HenriqDV/controlador-cultivo-esp32/docs/img/painel-automacao.png

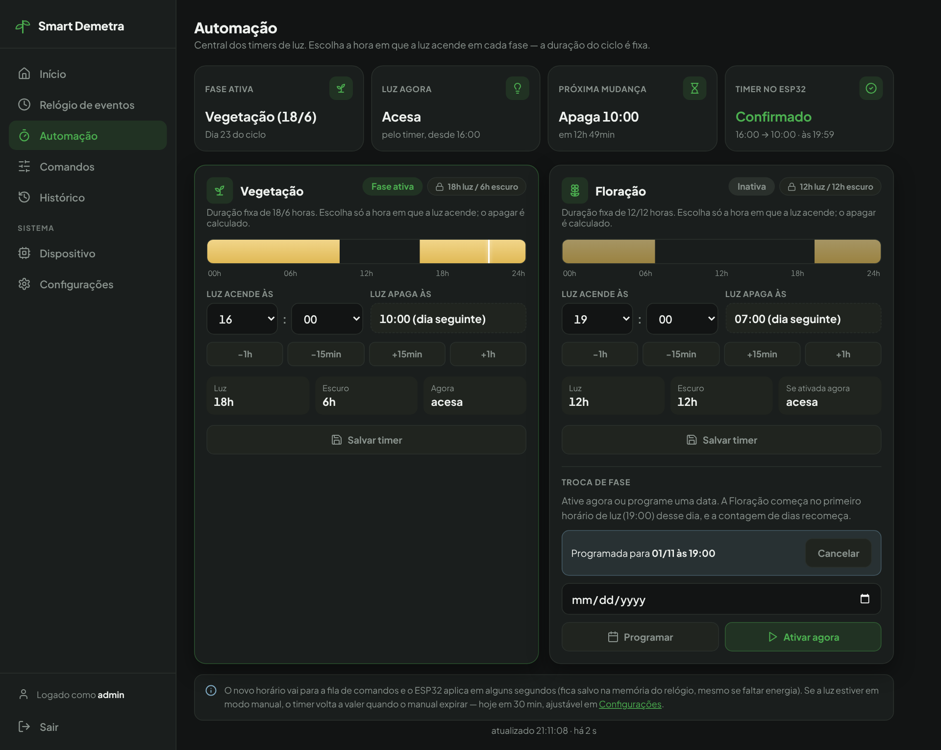
docs/img/painel-automacao.png
