HenriqDV/controlador-cultivo-esp32/src/main.cpp

// =============================================================================
//  CULTIVO — automação de estufa (ESP32-S3)
// =============================================================================
//  Luz (fotoperíodo + override manual), exaustores, trava de acesso e sensores
//  de temperatura/umidade do ar e do solo. Interface local: OLED SSD1306 +
//  botão. Interface remota: dashboard na Hostinger (pasta hostinger/), que o
//  ESP32 consulta por HTTPS (conexão reaproveitada), com o estado atual a cada
//  5 s para o painel ficar ao vivo. A rede roda numa tarefa no núcleo 0; o loop() fica no núcleo 1.
//  Não há servidor HTTP no dispositivo.
//  Gravação do firmware só por USB.
//
//  WOKWI_SIMULATION: 1 = simulador (DHT22; SSID "Wokwi-GUEST" no secrets.h)
//                    0 = hardware (SHT40 via I2C)
//
//  PINOS
//    I2C (OLED + RTC DS1307 + SHT40): SDA 8, SCL 9
//    Solo capacitivo v1.2 (ADC) 6 | Caixa d'água HC-SR04: TRIG 12, ECHO 13 (com divisor 5V->3,3V)
//    DHT externo 16 | DHT interno 15 (só simulação)
//    Buzzer 17 | NeoPixel 4 (Wokwi) / 48 (placa) | Botão OLED 5 | Botão trava 19
//    Relés {42,41,40,39,38,37,36,35}:
//      0 Luz  1 Irrigacao (pino 41)  2 Ventilador  3 Umidificador (pino 39)
//      4 Entrada de Ar (pino 38)  5 Aquecedor (pino 37)  6 Trava  7 Saída de Ar
//
//  NVRAM do RTC: bytes 0-7 relés/modo/override da luz, 8-12 horários de luz.
//  Cópia de tudo isso na flash (NVS "estado"), que não depende da bateria do RTC.
//  NVS "clima": clima por VPD (fase, faixa de VPD e travas do aquecedor/umidificador).
//
//  CALIBRAR NO HARDWARE: SOLO_MV_SECO/SOLO_MV_UMIDO, AGUA_SENSOR_ATE_FUNDO_CM, RELE_ATIVO_EM_BAIXO.
// =============================================================================

// Necessário em .cpp (o .ino incluía automaticamente).
#include <Arduino.h>
#include <Wire.h>
#include <Adafruit_GFX.h>
#include <Adafruit_SSD1306.h>
#include <RTClib.h>
#define WOKWI_SIMULATION 0

// Versão enviada ao painel (tela Dispositivo). Atualize a cada nova gravação.
#define FIRMWARE_VERSAO "2.9.0"
#if !WOKWI_SIMULATION
#include <Adafruit_SHT4x.h>
#endif
#include <DHT.h>
#include <Adafruit_NeoPixel.h>
#include <WiFi.h>
#include <WiFiClientSecure.h>
#include <HTTPClient.h>
#include <esp_task_wdt.h>
#include <ArduinoJson.h>
#include <Preferences.h>
#include <WiFiManager.h>
#include <time.h>
#include <math.h>

// Copie secrets.example.h para secrets.h (não versionado) e preencha.
#include "secrets.h"

// ---------------- WIFI E CONEXÃO COM O PAINEL ----------------
// O portal "SmartDemetra-Setup" (192.168.4.1) grava rede, endereço do painel e token
// na memória (NVS). Sem nada gravado, valem os valores do secrets.h.
const char* PORTAL_SSID = "SmartDemetra-Setup";
const unsigned long PORTAL_TIMEOUT_S = 300;         // fecha o portal após 5 min
const unsigned long BOTAO_PORTAL_MS = 3000;         // segurar o botão do OLED ao ligar
const unsigned long RETENTATIVA_VINCULO_MS = 30000;
const char* TOKEN_HW_PREFIXO = "sd_hw_";
Preferences prefs;
String cfgSsid, cfgSenha, cfgUrl, cfgToken, cfgVinculo;
unsigned long ultimaTentativaVinculoEm = 0;

// Envio de leitura pra Hostinger (independente do histórico local).
const unsigned long INTERVALO_ENVIO_LEITURA_HOSTINGER_MS = 60UL * 1000UL; // 1 minuto
unsigned long ultimoEnvioLeituraHostingerEm = 0;

const long GMT_OFFSET_SEC = -3 * 3600;
const int DAYLIGHT_OFFSET_SEC = 0;
const unsigned long WIFI_TIMEOUT_MS = 15000;
const unsigned long RETENTATIVA_WIFI_INICIAL_MS = 5000;
const unsigned long RETENTATIVA_WIFI_POSTERIOR_MS = 30000;
const unsigned long JANELA_WIFI_INICIAL_MS = 60000;
const unsigned long NTP_TIMEOUT_MS = 10000;
const unsigned long RETENTATIVA_NTP_MS = 60000;

// ---------------- PRAZOS COM millis() ----------------
// millis() volta a zero a cada 49,7 dias. Comparar "millis() >= prazo" falha perto da virada
// (ex.: a luz manual desligaria na hora). A diferença com sinal continua certa na virada.
inline bool prazoVencido(unsigned long prazo) { return (long)(millis() - prazo) >= 0; }
inline unsigned long msAtePrazo(unsigned long prazo) {
  long restante = (long)(prazo - millis());
  return restante > 0 ? (unsigned long)restante : 0;
}

// ---------------- HOSTINGER ----------------
// Toda a rede (HTTPS) roda numa tarefa própria no núcleo 0 (tarefaRede).
// O loop() fica no núcleo 1 com sensores, relés, OLED e clima, e nunca espera o servidor.
// As duas partes conversam só pelo que está protegido por mtxRede e pela fila de comandos.
const unsigned long HOSTINGER_HTTP_TIMEOUT_MS = 7000;
const unsigned long INTERVALO_ENVIO_COMANDOS_HOSTINGER_MS = 250; // eventos saem quase na hora
const int HOSTINGER_FILA_COMANDOS_MAX = 30;
String filaComandosHostinger[HOSTINGER_FILA_COMANDOS_MAX];   // protegida por mtxRede
int filaComandosInicio = 0;
int filaComandosFim = 0;
int filaComandosTotal = 0;
unsigned long ultimoEnvioComandoHostingerEm = 0;              // só na tarefa de rede

// Estado ao vivo pela própria Hostinger: leituras e relés a cada 5 s em estado_atual.php.
// O servidor guarda só o último (não cresce o banco); o histórico continua com 1 leitura por minuto.
const unsigned long INTERVALO_ESTADO_HOSTINGER_MS = 5000;
unsigned long ultimoEstadoHostingerEm = 0;                    // loop()

// Polling da fila de comandos do dashboard.
const unsigned long INTERVALO_POLL_COMANDOS_HOSTINGER_MS = 4UL * 1000UL; // 4 segundos
unsigned long ultimaConsultaComandosPendentesEm = 0;          // só na tarefa de rede

// ---------------- TAREFA DE REDE (núcleo 0) ----------------
const uint32_t TAREFA_REDE_PILHA = 16384;  // TLS precisa de pilha folgada
const UBaseType_t TAREFA_REDE_PRIORIDADE = 1;
const BaseType_t TAREFA_REDE_NUCLEO = 0;   // o loop() do Arduino roda no núcleo 1
SemaphoreHandle_t mtxRede = nullptr;       // protege filas e "caixas de correio" abaixo
QueueHandle_t filaComandosRemotos = nullptr; // rede -> loop(): comandos do painel a aplicar

struct ComandoRemoto {
  char tipo[24];
  char alvo[32];
  char valor[64];
};
const int FILA_COMANDOS_REMOTOS_MAX = 16;

// Caixas de correio loop() -> rede (sempre a versão mais recente; protegidas por mtxRede).
String leituraParaEnviar;
bool temLeituraParaEnviar = false;
String estadoParaHostinger;         // estado_atual.php
bool temEstadoParaHostinger = false;
// Rede -> loop(): mensagem curta para o OLED (ex.: "Vinculado!").
char mensagemRedeOLED[24] = "";
bool temMensagemRedeOLED = false;

// ---------------- VIGIA DA CONEXÃO ----------------
// O Wi-Fi pode continuar "conectado" sem os dados chegarem ao servidor (roteador sem internet,
// DNS, memória para TLS esgotada, conexão travada). Antes nada tentava recuperar: o aparelho
// seguia funcionando localmente sem enviar nada. O vigia (no loop) age em etapas:
//   3 min sem resposta do servidor  -> derruba e reconecta o Wi-Fi (repete a cada 3 min)
//   10 min sem resposta             -> reinicia o ESP32 (relés manuais, fase e luz voltam da memória)
//   tarefa de rede parada há 2 min  -> reinicia o ESP32
// Depois de 3 reinícios seguidos sem resposta (servidor fora do ar), só reinicia a cada 1 h.
// Qualquer resposta HTTP conta (até um erro 401/500 prova que a rede chega ao servidor).
const unsigned long VIGIA_INTERVALO_MS = 10000;
const unsigned long VIGIA_RECONECTAR_WIFI_MS = 3UL * 60UL * 1000UL;
const unsigned long VIGIA_REINICIAR_MS = 10UL * 60UL * 1000UL;
const unsigned long VIGIA_REINICIAR_ESPACADO_MS = 60UL * 60UL * 1000UL;
const unsigned long VIGIA_TAREFA_TRAVADA_MS = 2UL * 60UL * 1000UL;
const uint32_t VIGIA_REINICIOS_ANTES_DE_ESPACAR = 3;
const unsigned long STATUS_REDE_SERIAL_MS = 60000;
// Watchdog do loop(): se ele parar por mais que isto (ex.: barramento I2C travado), o ESP32 reinicia.
const uint32_t WATCHDOG_LOOP_S = 15;
volatile unsigned long ultimaRespostaServidorEm = 0;  // rede: qualquer resposta HTTP
volatile unsigned long ultimaVoltaTarefaRedeEm = 0;   // rede: prova de vida da tarefa
volatile uint32_t falhasSeguidasServidor = 0;         // rede
bool tarefaRedeIniciada = false;
unsigned long vigiaReferenciaEm = 0;                  // loop(): início da contagem (Wi-Fi conectado)
unsigned long ultimaVerificacaoVigiaEm = 0;
unsigned long ultimaReconexaoForcadaEm = 0;
unsigned long ultimoStatusRedeSerialEm = 0;
// Sobrevivem ao ESP.restart() (não à falta de energia): por que o vigia reiniciou.
const uint32_t VIGIA_MARCADOR = 0x56494741;
RTC_NOINIT_ATTR uint32_t vigiaMarcador;
RTC_NOINIT_ATTR uint32_t vigiaReiniciosSeguidos;
RTC_NOINIT_ATTR uint32_t vigiaMotivo;          // 0 = nenhum, 1 = sem resposta do servidor, 2 = tarefa de rede travada
RTC_NOINIT_ATTR uint32_t vigiaSemRespostaSeg;

// Trava o mutex no construtor e solta no destrutor (não esquece de soltar em return).
struct TravaRede {
  TravaRede() { xSemaphoreTake(mtxRede, portMAX_DELAY); }
  ~TravaRede() { xSemaphoreGive(mtxRede); }
};


// ---------------- PINOS ----------------
#define SDA_PIN 8
#define SCL_PIN 9

#if WOKWI_SIMULATION
#define DHTPIN 15
#define DHTTYPE DHT22
#endif

// Sensor externo: DHT11 no hardware, DHT22 no Wokwi.
#define DHT_EXT_PIN 16
#if WOKWI_SIMULATION
#define DHT_EXT_TYPE DHT22
#else
#define DHT_EXT_TYPE DHT11
#endif

#define SOIL_PIN 6

// ---------------- SENSOR DE SOLO: Capacitive Soil Moisture Sensor v1.2 ----------------
// Saída analógica que CAI com a umidade: ~2,7 V no ar (seco) e ~1,1 V na água, alimentado em 3,3 V.
// Lido em milivolts (analogReadMilliVolts usa a calibração de fábrica do ADC do ESP32-S3).
// CALIBRAR: veja "Solo - mV" no monitor serial com o sensor no ar (SOLO_MV_SECO) e com ele
// mergulhado em água até a linha branca da placa, sem molhar os componentes (SOLO_MV_UMIDO).
const int SOLO_MV_SECO = 2700;           // mV com o sensor no ar
const int SOLO_MV_UMIDO = 1100;          // mV com o sensor na água
const int SOLO_MV_MINIMO_VALIDO = 300;   // abaixo: sensor solto ou sem alimentação
const int SOLO_MV_MAXIMO_VALIDO = 3150;  // acima: fio de sinal solto (entrada flutuando)
const int SOLO_AMOSTRAS = 16;            // leituras por ciclo; descarta as 4 maiores e as 4 menores
const int SOLO_FALHAS_PARA_INVALIDAR = 3; // ciclos seguidos fora da faixa até marcar "sem leitura"

// ---------------- CAIXA D'ÁGUA: sensor ultrassônico HC-SR04 ----------------
// Fica na tampa, virado para baixo. O ECHO do HC-SR04 sai em 5 V: ligue por um divisor
// (ECHO -> 1 kΩ -> pino 13 -> 2 kΩ -> GND) para não danificar o ESP32-S3. VCC em 5 V.
#define AGUA_TRIG_PIN 12
#define AGUA_ECHO_PIN 13
const float CAIXA_COMPRIMENTO_CM = 66.0f;
const float CAIXA_LARGURA_CM = 36.0f;
const float CAIXA_ALTURA_CM = 35.0f;
const float CAIXA_CAPACIDADE_L = 70.0f;        // capacidade útil (100%); paredes retas, 66 x 36 = 2,376 L por cm (70 L = 29,5 cm)
const float AGUA_SENSOR_ATE_FUNDO_CM = 35.0f;  // CALIBRAR: da face do sensor até o fundo (caixa vazia)
const float AGUA_DISTANCIA_MINIMA_CM = 3.0f;   // zona cega do HC-SR04
const unsigned long INTERVALO_AGUA_MS = 10000; // mede a cada 10 s
const int AGUA_PINGS = 5;                      // usa a mediana de 5 medições
const unsigned long AGUA_ENTRE_PINGS_MS = 70;  // espera o eco anterior sumir
const unsigned long AGUA_TIMEOUT_US = 6000;    // ~1 m ida e volta; não trava o loop
const int AGUA_FALHAS_PARA_INVALIDAR = 3;      // ciclos seguidos sem eco até marcar "sem leitura"
const float AGUA_PROTECAO_IRRIGACAO_PCT = 10.0f; // abaixo disso a irrigação desliga e fica bloqueada (bomba não roda a seco)

#define BOTAO_OLED_PIN 5
#define BOTAO_TRV_PIN 19

#define BUZZER 17

// NeoPixel: LED externo no Wokwi, LED RGB da placa no hardware.
#if WOKWI_SIMULATION
#define LED_PIN 4
#else
#define LED_PIN 48
#endif

// Troque para false se os relés ligarem invertidos.
#define RELE_ATIVO_EM_BAIXO true

int reles[8] = {42, 41, 40, 39, 38, 37, 36, 35};
// Placas com PSRAM Octal (ex.: N16R8) reservam GPIO35-37: remapeie se for o caso.

// ---------------- ÍNDICES DOS RELÉS ----------------
const int TOTAL_RELES = 8;           // índices 0-7
const int RELE_LUZ = 0;              // ver controlarLuz()
const int RELE_IRRIGACAO = 1;        // "Irrigacao" (pino 41)
const int RELE_VENTILADOR = 2;       // "Ventilador"
const int RELE_UMIDIFICADOR = 3;     // "Umidificador" (pino 39)
const int RELE_ENTRADA_AR = 4;       // "Entrada de Ar" (pino 38)
const int RELE_AQUECEDOR = 5;        // "Aquecedor" (pino 37)
const int RELE_ACESSO = 6;           // trava (pulso)
const int RELE_SAIDA_AR = 7;         // "Saida de Ar" (exaustor de saída)
const int PRIMEIRO_RELE_MANUAL = 1;  // menor índice de relé "manual" (usado só como limite de segurança)
const int CONTROLE_MODO_CULTIVO = -1; // sentinela: item de menu "Modo Cultivo" (não é relé de verdade)
const int CONTROLE_LUZ_MANUAL = -2;   // sentinela: item de menu "Luz Manual" (override, não é relé de verdade)

// Relés exibidos no menu e no dashboard (luz e trava têm controle próprio).
const int RELES_MANUAIS[] = {RELE_IRRIGACAO, RELE_VENTILADOR, RELE_UMIDIFICADOR, RELE_ENTRADA_AR, RELE_AQUECEDOR, RELE_SAIDA_AR};
const int TOTAL_RELES_MANUAIS = sizeof(RELES_MANUAIS) / sizeof(RELES_MANUAIS[0]);

// ---------------- DISPLAY OLED ----------------
#define SCREEN_WIDTH 128
#define SCREEN_HEIGHT 64
#define OLED_RESET -1
#define SCREEN_ADDRESS 0x3C
Adafruit_SSD1306 display(SCREEN_WIDTH, SCREEN_HEIGHT, &Wire, OLED_RESET);

// Painel com faixa amarela de 16px no topo.
const int OLED_ALTURA_CABECALHO = 16;                       // faixa amarela (linhas 0-15)
const int OLED_CONTEUDO_TOPO = OLED_ALTURA_CABECALHO + 2;    // margem de 2px após a costura

// ---------------- OBJETOS ----------------
RTC_DS1307 rtc;
#if WOKWI_SIMULATION
DHT dht(DHTPIN, DHTTYPE);
#else
Adafruit_SHT4x sht4 = Adafruit_SHT4x();
#endif
DHT dhtExterno(DHT_EXT_PIN, DHT_EXT_TYPE);
Adafruit_NeoPixel pixel(1, LED_PIN, NEO_GRB + NEO_KHZ800);

// ---------------- LED (cor = zona do VPD) ----------------
unsigned long tempoLED = 0; // efeito a cada 20ms
int brilho = 30;
int direcao = 5; // sentido do "respirar" (+ = aumentando, - = diminuindo)
const int LED_BRILHO_MIN = 30;  // nunca apaga de vez — sempre dá pra ver a cor
const int LED_BRILHO_MAX = 150;

// ---------------- CULTIVO ----------------
enum ModoCultivo { VEGETACAO, FLORACAO };
ModoCultivo modoAtual = VEGETACAO;

// Fotoperíodo: início configurável pelo dashboard, duração fixa (18/6 e 12/12).
const int DURACAO_LUZ_VEGETACAO_MIN = 18 * 60;
const int DURACAO_LUZ_FLORACAO_MIN = 12 * 60;
const int INICIO_LUZ_VEGETACAO_PADRAO_MIN = 16 * 60;
const int INICIO_LUZ_FLORACAO_PADRAO_MIN = 19 * 60;
int inicioLuzVegetacaoMin = INICIO_LUZ_VEGETACAO_PADRAO_MIN;
int inicioLuzFloracaoMin = INICIO_LUZ_FLORACAO_PADRAO_MIN;

// Override manual da luz: expira sozinho e o timer segue contando por baixo.
enum ModoControleLuz { LUZ_AUTOMATICA, LUZ_MANUAL_LIGADA, LUZ_MANUAL_DESLIGADA };
ModoControleLuz modoControleLuz = LUZ_AUTOMATICA;
unsigned long overrideLuzAte = 0;
const unsigned long DURACAO_OVERRIDE_LUZ_MS = 30UL * 60UL * 1000UL; // padrão, se o painel não enviar outra
int duracaoOverrideLuzMin = 30;  // 15, 30, 60 ou 120 (Configurações → Luz, salvo na flash e no RTC)
const int DURACAO_LUZ_MANUAL_MAX_MIN = 120;
unsigned long duracaoOverrideLuzMs() {
  return duracaoOverrideLuzMin > 0 ? (unsigned long)duracaoOverrideLuzMin * 60UL * 1000UL : DURACAO_OVERRIDE_LUZ_MS;
}

// ---------------- OLED / BOTÃO ----------------
// Clique curto: próxima tela/item. Clique longo: entra no menu/alterna item.
enum TelaOLED {
  TELA_PRINCIPAL,      // temperatura/umidade interna e externa
  TELA_CONFIGURACAO,    // menu com abas "Dispositivos" (relés) e "Status"
  TOTAL_TELAS_OLED
};

enum EstadoOLED {
  OLED_DESCANSO,   // tela de descanso
  OLED_MENU,       // aguardando clique longo
  OLED_EXIBINDO,   // exibindo uma TelaOLED
  OLED_MENSAGEM    // mensagem temporária centralizada (ex: "Modo: Floracao")
};

EstadoOLED estadoOLED = OLED_DESCANSO;
TelaOLED telaSelecionada = TELA_PRINCIPAL;
bool mensagemTemporariaAtiva = false;
unsigned long mensagemAte = 0;      // timestamp em que a mensagem temporária deve sumir
String linha1Mensagem = "";
bool atualizarOLED = true;          // "dirty flag": true = precisa redesenhar no próximo loop()
unsigned long oledVoltaDescansoEm = 0; // volta ao descanso (0 = desativado)
unsigned long ultimoRefreshPeriodicoOLED = 0; // ver INTERVALO_REFRESH_PERIODICO_MS, no loop()

// --- Debounce e detecção de clique curto/longo do botão físico ---
bool ultimoEstadoBotao = HIGH;
bool estadoEstavelBotaoOLED = HIGH;
bool botaoPressionado = false;
unsigned long botaoMudouEm = 0;
unsigned long botaoPressionadoEm = 0;
const unsigned long DEBOUNCE_BOTAO_MS = 50;    // ignora oscilações do contato mecânico abaixo disso
const unsigned long PRESSAO_LONGA_MS = 1200;   // acima disso, conta como "clique longo"
const unsigned long TEMPO_EXIBICAO_OLED_MS = 15000; // tempo de inatividade até voltar pra tela de descanso
const unsigned long INTERVALO_REFRESH_PERIODICO_MS = 1000; // redesenho periódico
const unsigned long INTERVALO_ANIMACAO_DESCANSO_MS = 60;   // ~16 fps para a animação sol/lua
unsigned long ultimoFrameAnimacaoDescanso = 0;
int releSelecionadoControle = CONTROLE_MODO_CULTIVO; // item atualmente destacado no menu de configuração

// ---------------- SENSOR DE AR (DHT22 no Wokwi / SHT40 no hardware) ----------------
float tempAtual = NAN;
float umidAtual = NAN;
unsigned long ultimoDHT = 0;
const unsigned long INTERVALO_DHT_MS = 2000; // intervalo mínimo recomendado p/ DHT22; SHT40 aceita mais rápido
bool pulsoSensorAtivo = false;      // indicador visual de "sensor vivo" (bolinha ao lado de "Interna", na TELA_PRINCIPAL)
unsigned long pulsoSensorAte = 0;
const unsigned long DURACAO_PULSO_SENSOR_MS = 300; // por quanto tempo o pulso fica visível a cada leitura

// ---------------- SENSOR EXTERNO (DHT) ----------------
float tempExterna = NAN;
float umidExterna = NAN;
unsigned long ultimoDHTExterno = 0;
const unsigned long INTERVALO_DHT_EXTERNO_MS = 2000; // seguro tanto para DHT11 (>=1s) quanto DHT22 (>=2s)
bool pulsoSensorExternoAtivo = false;
unsigned long pulsoSensorExternoAte = 0;

// ---------------- SOLO ----------------
int soloMv = 0;          // leitura em mV (útil p/ calibrar)
int soloPercentual = 0;  // 0 = seco, 100 = encharcado, já calibrado
bool soloValido = false; // false = sensor sem leitura (solto/sem alimentação); envia null ao servidor
int soloFalhas = 0;

// Caixa d'água (NAN = sem leitura)
float aguaDistanciaCm = NAN;
float aguaNivelCm = NAN;
float aguaLitros = NAN;
float aguaPercentual = NAN;
float pingsAgua[AGUA_PINGS];
int pingsAguaFeitos = 0;
int aguaFalhas = 0;
unsigned long ultimoCicloAguaEm = 0;
unsigned long ultimoPingAguaEm = 0;
unsigned long ultimoSolo = 0;
const unsigned long INTERVALO_SOLO_MS = 1000;
bool pulsoSensorSoloAtivo = false;  // indicador visual de "sensor vivo" (bolinha ao lado de "Solo", na TELA_PRINCIPAL)
unsigned long pulsoSensorSoloAte = 0;

// ---------------- BUZZER (não bloqueante) ----------------
bool buzzerLigado = false;
unsigned long buzzerDesligaEm = 0;

// ---------------- ACESSO (trava, pulso) ----------------
bool acessoAtivo = false;
unsigned long acessoDesligaEm = 0;

// ---------------- STATUS (conectividade e sincronismo) ----------------
bool rtcDisponivel = false;             // RTC DS1307 detectado no I2C
bool rtcPerdeuHora = false;             // RTC estava parado ao ligar (sem bateria): hora não confiável até o NTP
#if !WOKWI_SIMULATION
bool sht40Disponivel = false;           // SHT40 detectado (hardware)
#endif
bool wifiConectado = false;
bool horaSincronizada = false;          // NTP sincronizado desde o boot
unsigned long ultimaTentativaWiFi = 0;
unsigned long wifiDesconectadoDesde = 0;
unsigned long ultimaTentativaNTP = 0;
unsigned long ultimaInteracaoMenuEm = 0;      // marca a última interação local com o menu do OLED

// ---------------- ESTADO DOS RELÉS (escrito só por acionarRele()) ----------------
bool estadoReles[TOTAL_RELES] = {false, false, false, false, false, false, false, false};

// ---------------- PROTÓTIPOS ----------------
void beep(unsigned long tempo = 200);
void avancarReleControle();
void alternarReleSelecionado();
void alternarModoCultivo();
void alternarModoControleLuz();
bool telaInterativa(TelaOLED tela);
TelaOLED proximaTelaOLED(TelaOLED telaAtualBase);
void abrirTelaRapidaOLED();
void avancarNavegacaoOLED();
const char* nomeReleControle(int indiceRele);
bool conectarWiFi();
void atualizarConexaoWiFi();
String obterTimestampAtual();
void registrarEventoModo(const char* estadoModo, const char* origem = "sistema");
void registrarEventoAcesso(const char* origem, const char* resultado);
void registrarEventoRele(int indiceRele, bool ligado, const char* origem);
bool enviarJsonHostinger(const char* endpoint, const String& payload);
void enviarLeituraHostinger();
void atualizarEnvioLeituraHostinger();
void enfileirarComandoHostinger(const char* tipo, const char* alvo, const String& valor, const char* origem);
void atualizarFilaComandosHostinger();
String valorJsonFloat(float valor, int casas);
String escaparJson(const String& valor);
float calcularVPD(float tempC, float umidPercent);
uint32_t corParaVPD(float vpd);
void atualizarLEDVPD();
void aplicarComandoRele(int indiceRele, int valor);
void acionarRele(int numero, bool ligado);
void pausarClimaDoRele(int indiceRele, const char* origem);
void definirModoCultivoRemoto(ModoCultivo novoModo);
void definirModoControleLuzRemoto(ModoControleLuz novoModo);
void liberarAcessoRemoto();
DateTime obterAgora();
String tempoRestante(const DateTime& now);
String tempoRestanteOverrideLuz();
void salvarEstadoNaMemoria();
void restaurarEstadoDaMemoria();
void salvarFotoperiodoNaMemoria();
void restaurarFotoperiodoDaMemoria();
void registrarEventoFotoperiodo(ModoCultivo modo, const char* origem);
void definirFotoperiodoRemoto(ModoCultivo modo, int inicioMin);
void mensagemInicializacao(const String& linha1, const String& linha2 = "");
void atualizarComandosPendentesHostinger();
void aplicarComandoRemotoWeb(const String& tipo, const String& alvo, const String& valor);
int requisicaoHttps(const char* endpoint, const String* corpo, bool comChave, String* resposta);
void avisarOLEDPelaRede(const char* texto);
String montarJsonEstado();
void mostrarMensagemTemporaria(const String& linha1, unsigned long duracaoMs);

// ---------------- VPD ----------------
// VPD (kPa) = 0.6108 * e^(17.27*T/(T+237.3)) * (1 - UR/100)
float calcularVPD(float tempC, float umidPercent) {
  float svp = 0.6108 * exp((17.27 * tempC) / (tempC + 237.3));
  return svp * (1.0 - umidPercent / 100.0);
}

// Zonas: <0.4 muito úmido | 0.4-0.8 propagação | 0.8-1.2 veg tardio/flora inicial
//        | 1.2-1.6 flora | >1.6 muito seco
uint32_t corParaVPD(float vpd) {
  if (vpd < 0.4) {
    return pixel.Color(171, 0, 37);     // rosa fraco #AB0025 — muito úmido
  } else if (vpd < 0.8) {
    return pixel.Color(254, 105, 255);  // rosa forte #FE69FF — propagação/veg inicial
  } else if (vpd < 1.2) {
    return pixel.Color(14, 173, 49);    // verde #0EAD31 — fim de veg / início de flora
  } else if (vpd < 1.6) {
    return pixel.Color(219, 203, 15);   // laranja #DBCB0F — flora média/tardia
  } else {
    return pixel.Color(171, 0, 37);     // rosa fraco #AB0025 — muito seco
  }
}

// Cor pela zona do VPD com efeito de respiração (~50Hz).
void atualizarLEDVPD() {
  if (millis() - tempoLED < 20) return;
  tempoLED = millis();

  brilho += direcao;
  if (brilho >= LED_BRILHO_MAX) {
    brilho = LED_BRILHO_MAX;
    direcao = -5;
  }
  if (brilho <= LED_BRILHO_MIN) {
    brilho = LED_BRILHO_MIN;
    direcao = 5;
  }

  if (isnan(tempAtual) || isnan(umidAtual)) {
    // Sem leitura ainda: branco fraco.
    uint8_t nivel = brilho / 3;
    pixel.setPixelColor(0, pixel.Color(nivel, nivel, nivel));
  } else {
    uint32_t corBase = corParaVPD(calcularVPD(tempAtual, umidAtual));
    uint8_t rBase = (corBase >> 16) & 0xFF;
    uint8_t gBase = (corBase >> 8) & 0xFF;
    uint8_t bBase = corBase & 0xFF;
    uint8_t r = (uint16_t)rBase * brilho / LED_BRILHO_MAX;
    uint8_t g = (uint16_t)gBase * brilho / LED_BRILHO_MAX;
    uint8_t b = (uint16_t)bBase * brilho / LED_BRILHO_MAX;
    pixel.setPixelColor(0, pixel.Color(r, g, b));
  }

  pixel.show();
}

// Proteção da bomba: com a caixa abaixo de 10% a irrigação não liga. Sem leitura do sensor, não bloqueia.
bool irrigacaoBloqueadaPelaAgua() {
  return !isnan(aguaPercentual) && aguaPercentual < AGUA_PROTECAO_IRRIGACAO_PCT;
}

// Comando de relé vindo do dashboard; ignora se o estado já é o pedido.
void aplicarComandoRele(int indiceRele, int valor) {
  bool novoEstado = valor == 1;
  if (indiceRele == RELE_IRRIGACAO && novoEstado && irrigacaoBloqueadaPelaAgua()) {
    // Recusa e confirma ao painel que a irrigação continua desligada.
    registrarEventoRele(RELE_IRRIGACAO, false, "bloqueio_agua");
    Serial.println("Irrigacao bloqueada: caixa d'agua abaixo de 10%");
    return;
  }
  pausarClimaDoRele(indiceRele, "web"); // comando manual tem prioridade sobre o clima por VPD
  if (estadoReles[indiceRele] == novoEstado) return;

  acionarRele(indiceRele, novoEstado);
  registrarEventoRele(indiceRele, novoEstado, "web");
  salvarEstadoNaMemoria();
  atualizarOLED = true;
}

// =========================================================================
//                              OLED - SSD1306
// =========================================================================

// Mensagem centralizada por duracaoMs; depois volta à tela de descanso.
void mostrarMensagemTemporaria(const String& linha1, unsigned long duracaoMs) {
  estadoOLED = OLED_MENSAGEM;
  linha1Mensagem = linha1;
  mensagemTemporariaAtiva = true;
  mensagemAte = millis() + duracaoMs;
  oledVoltaDescansoEm = mensagemAte;
  atualizarOLED = true;
}

// Fecha a mensagem temporária quando o tempo expira (chamada a cada loop()).
void atualizarMensagemTemporaria() {
  if (mensagemTemporariaAtiva && prazoVencido(mensagemAte)) {
    mensagemTemporariaAtiva = false;
    atualizarOLED = true;
  }
}

bool telaInterativa(TelaOLED tela) {
  return tela == TELA_CONFIGURACAO;
}

TelaOLED proximaTelaOLED(TelaOLED telaAtualBase) {
  int proximaTela = static_cast<int>(telaAtualBase) + 1;
  if (proximaTela >= TOTAL_TELAS_OLED) {
    proximaTela = 0;
  }
  return static_cast<TelaOLED>(proximaTela);
}

void abrirTelaRapidaOLED() {
  telaSelecionada = TELA_PRINCIPAL;
  estadoOLED = OLED_EXIBINDO;
  oledVoltaDescansoEm = millis() + TEMPO_EXIBICAO_OLED_MS;
  ultimaInteracaoMenuEm = millis();
  atualizarOLED = true;
}

// Clique longo no menu: abre a lista de dispositivos no primeiro item.
void selecionarTelaOLED() {
  estadoOLED = OLED_EXIBINDO;
  if (telaSelecionada == TELA_CONFIGURACAO) {
    releSelecionadoControle = CONTROLE_MODO_CULTIVO;
  }
  oledVoltaDescansoEm = millis() + TEMPO_EXIBICAO_OLED_MS;
  ultimaInteracaoMenuEm = millis();
  atualizarOLED = true;
}

// Volta à tela de descanso após o tempo sem interação.
void atualizarTimeoutOLED() {
  if (estadoOLED != OLED_DESCANSO && oledVoltaDescansoEm != 0 && prazoVencido(oledVoltaDescansoEm)) {
    estadoOLED = OLED_DESCANSO;
    mensagemTemporariaAtiva = false;
    oledVoltaDescansoEm = 0;
    atualizarOLED = true;
  }
}

// Telas interativas param em OLED_MENU aguardando clique longo.
void avancarNavegacaoOLED() {
  telaSelecionada = proximaTelaOLED(telaSelecionada);
  estadoOLED = telaInterativa(telaSelecionada) ? OLED_MENU : OLED_EXIBINDO;
  oledVoltaDescansoEm = millis() + TEMPO_EXIBICAO_OLED_MS;
  ultimaInteracaoMenuEm = millis();
  atualizarOLED = true;
}

// Clique curto: acorda o display, alterna Informações/Configurações ou avança item.
void tratarCliqueCurtoBotaoOLED() {
  if (estadoOLED == OLED_DESCANSO) {
    abrirTelaRapidaOLED();
    return;
  }

  if (estadoOLED == OLED_EXIBINDO && telaSelecionada == TELA_CONFIGURACAO) {
    avancarReleControle();
    return;
  }

  if (estadoOLED == OLED_EXIBINDO || estadoOLED == OLED_MENU) {
    avancarNavegacaoOLED();
  }
}

// Debounce + diferencia clique curto de longo.
void atualizarBotaoOLED() {
  bool leitura = digitalRead(BOTAO_OLED_PIN);

  if (leitura != ultimoEstadoBotao) {
    botaoMudouEm = millis();
    ultimoEstadoBotao = leitura;
  }

  if (millis() - botaoMudouEm < DEBOUNCE_BOTAO_MS) {
    return;
  }

  if (leitura == estadoEstavelBotaoOLED) {
    return;
  }

  estadoEstavelBotaoOLED = leitura;
  ultimaInteracaoMenuEm = millis();

  if (estadoEstavelBotaoOLED == LOW) {
    botaoPressionado = true;
    botaoPressionadoEm = millis();
    return;
  }

  if (botaoPressionado) {
    unsigned long tempoPressionado = millis() - botaoPressionadoEm;
    botaoPressionado = false;

    if (tempoPressionado >= PRESSAO_LONGA_MS && estadoOLED == OLED_MENU) {
      beep(80);
      selecionarTelaOLED();
    } else if (tempoPressionado >= PRESSAO_LONGA_MS &&
               estadoOLED == OLED_EXIBINDO &&
               telaSelecionada == TELA_CONFIGURACAO) {
      beep(80);
      alternarReleSelecionado();
    } else if (tempoPressionado >= DEBOUNCE_BOTAO_MS) {
      beep(80);
      tratarCliqueCurtoBotaoOLED();
    }
  }
}

// ---------- desenho: primitivas auxiliares ----------

// Ícone de WiFi desenhado pixel a pixel (vazio quando desconectado).
void desenharIconeConexao(int x, int y) {
  if (!wifiConectado) return;

  int cx = x + 4; // centro horizontal do ícone
  int cy = y + 7; // "base" do leque (pontinho fica aqui)

  // Pontinho central
  display.drawPixel(cx, cy, SSD1306_WHITE);

  // Arco interno
  display.drawPixel(cx - 2, cy - 2, SSD1306_WHITE);
  display.drawPixel(cx - 1, cy - 3, SSD1306_WHITE);
  display.drawPixel(cx,     cy - 3, SSD1306_WHITE);
  display.drawPixel(cx + 1, cy - 3, SSD1306_WHITE);
  display.drawPixel(cx + 2, cy - 2, SSD1306_WHITE);

  // Arco externo
  display.drawPixel(cx - 5, cy - 3, SSD1306_WHITE);
  display.drawPixel(cx - 4, cy - 4, SSD1306_WHITE);
  display.drawPixel(cx - 3, cy - 5, SSD1306_WHITE);
  display.drawPixel(cx - 2, cy - 6, SSD1306_WHITE);
  display.drawPixel(cx - 1, cy - 6, SSD1306_WHITE);
  display.drawPixel(cx,     cy - 6, SSD1306_WHITE);
  display.drawPixel(cx + 1, cy - 6, SSD1306_WHITE);
  display.drawPixel(cx + 2, cy - 6, SSD1306_WHITE);
  display.drawPixel(cx + 3, cy - 5, SSD1306_WHITE);
  display.drawPixel(cx + 4, cy - 4, SSD1306_WHITE);
  display.drawPixel(cx + 5, cy - 3, SSD1306_WHITE);
}

// Cabeçalho comum: título, hora, modo (V/F) e WiFi; ocupa a faixa amarela.
void desenharCabecalho(const DateTime& now, const char* titulo) {
  display.setTextSize(1);
  display.setTextColor(SSD1306_WHITE);

  // Texto e ícone centralizados verticalmente dentro da faixa amarela (0-15)
  const int y = 4;

  display.setCursor(0, y);
  display.print(titulo);

  char buf[12];
  snprintf(buf, sizeof(buf), "%02d:%02d", now.hour(), now.minute());
  display.setCursor(SCREEN_WIDTH - 57, y);
  display.print(buf);

  // Modo de cultivo abreviado: V = vegetativo, F = floração.
  display.setCursor(SCREEN_WIDTH - 24, y);
  display.print(modoAtual == VEGETACAO ? "V" : "F");

  desenharIconeConexao(SCREEN_WIDTH - 13, y);

  // Separador exatamente na costura entre a faixa amarela e a azul
  display.drawFastHLine(0, OLED_ALTURA_CABECALHO - 1, SCREEN_WIDTH, SSD1306_WHITE);
}

// Formato BR (vírgula); "--,-" se NAN.
String formatarTemperatura(float valor) {
  if (isnan(valor)) return "--,-";

  char buffer[10];
  dtostrf(valor, 4, 1, buffer);
  String texto = String(buffer);
  texto.trim();
  texto.replace(".", ",");
  return texto;
}

// Formato BR, 2 casas; "--" se NAN.
String formatarVPD(float valor) {
  if (isnan(valor)) return "--";

  char buffer[10];
  dtostrf(valor, 4, 2, buffer);
  String texto = String(buffer);
  texto.trim();
  texto.replace(".", ",");
  return texto;
}

// Texto curto do rodapé da tela principal ("45%" ou "--" sem leitura).
String textoPercentual(bool valido, float valor) {
  if (!valido || isnan(valor)) return "--";
  return String((int)roundf(valor)) + "%";
}

// ---------- tela principal: interna x externa + linha do solo ----------
// Rótulos curtos ("T:"/"U:") para caber em colunas de ~62px.
void desenharConteudoPrincipal() {
  const int xDivisor = 64;              // linha vertical central
  const int xColunaExterna = xDivisor + 4;
  const int yDivisorSala = OLED_CONTEUDO_TOPO + 29;

  display.setTextSize(1);

  // --- Linha 1: nome de cada sensor + indicador de "sensor vivo" ---
  int yLabel = OLED_CONTEUDO_TOPO;
  int dotInternaX = 3;
  int dotInternaY = yLabel + 3;
  if (pulsoSensorAtivo) {
    display.fillCircle(dotInternaX, dotInternaY, 3, SSD1306_WHITE);
  } else {
    display.drawCircle(dotInternaX, dotInternaY, 3, SSD1306_WHITE);
  }
  display.setCursor(dotInternaX + 6, yLabel);
  display.print("Interna");

  int dotExternaX = xColunaExterna + 3;
  int dotExternaY = yLabel + 3;
  if (pulsoSensorExternoAtivo) {
    display.fillCircle(dotExternaX, dotExternaY, 3, SSD1306_WHITE);
  } else {
    display.drawCircle(dotExternaX, dotExternaY, 3, SSD1306_WHITE);
  }
  display.setCursor(dotExternaX + 6, yLabel);
  display.print("Externa");

  // --- Linha 2: temperatura ---
  int yTemp = yLabel + 10;
  display.setCursor(0, yTemp);
  display.print("T: ");
  display.print(formatarTemperatura(tempAtual));
  display.write(248); // símbolo de grau
  display.print("C");

  display.setCursor(xColunaExterna, yTemp);
  display.print("T: ");
  display.print(formatarTemperatura(tempExterna));
  display.write(248);
  display.print("C");

  // --- Linha 3: umidade ---
  int yUmid = yTemp + 10;
  display.setCursor(0, yUmid);
  display.print("U: ");
  if (isnan(umidAtual)) {
    display.print("--");
  } else {
    display.print(umidAtual, 0);
  }
  display.print("%");

  display.setCursor(xColunaExterna, yUmid);
  display.print("U: ");
  if (isnan(umidExterna)) {
    display.print("--");
  } else {
    display.print(umidExterna, 0);
  }
  display.print("%");

  // --- Separador horizontal antes da linha final ---
  display.drawFastHLine(0, yDivisorSala, SCREEN_WIDTH, SSD1306_WHITE);

  // --- Última linha: status do solo ---
  int ySala = yDivisorSala + 3;
  int dotSoloX = 3;
  int dotSoloY = ySala + 3;
  if (pulsoSensorSoloAtivo) {
    display.fillCircle(dotSoloX, dotSoloY, 3, SSD1306_WHITE);
  } else {
    display.drawCircle(dotSoloX, dotSoloY, 3, SSD1306_WHITE);
  }
  display.setCursor(dotSoloX + 6, ySala);
  display.print("Solo ");
  display.print(textoPercentual(soloValido, soloPercentual));

  // --- Caixa d'água no mesmo rodapé, coluna da direita ---
  display.setCursor(xColunaExterna, ySala);
  display.print("Agua ");
  display.print(textoPercentual(!isnan(aguaPercentual), aguaPercentual));

  // --- Separador vertical (não desce até a linha do solo) ---
  display.drawFastVLine(xDivisor, OLED_CONTEUDO_TOPO - 1, yDivisorSala - (OLED_CONTEUDO_TOPO - 1), SSD1306_WHITE);
}

// ---------- tela de configuração ----------
// Índice do item no menu -> código em releSelecionadoControle (CONTROLE_* ou relé).
int itemIndexParaRele(int indiceItem) {
  if (indiceItem == 0) return CONTROLE_MODO_CULTIVO;
  if (indiceItem == 1) return CONTROLE_LUZ_MANUAL;
  int posManual = indiceItem - 2;
  if (posManual < 0 || posManual >= TOTAL_RELES_MANUAIS) return CONTROLE_MODO_CULTIVO; // segurança
  return RELES_MANUAIS[posManual];
}

// Inverso de itemIndexParaRele().
int releParaItemIndex(int releCodigo) {
  for (int i = 0; i < TOTAL_RELES_MANUAIS; i++) {
    if (RELES_MANUAIS[i] == releCodigo) {
      return i + 2;
    }
  }
  return 0; // fallback
}

// Texto curto do estado do override de luz, usado no menu de configuração.
const char* textoModoControleLuz() {
  switch (modoControleLuz) {
    case LUZ_MANUAL_LIGADA: return "ON";
    case LUZ_MANUAL_DESLIGADA: return "OFF";
    case LUZ_AUTOMATICA:
    default: return "Auto";
  }
}

// Legenda "Dispositivos | Status" no topo da lista.
const int OLED_CABECALHO_TABELA_ALTURA = 10;
const int OLED_CABECALHO_TABELA_DIVISOR_X = 82;

void desenharCabecalhoTabela(bool mostrarSeta) {
  const int yTopo = OLED_CONTEUDO_TOPO;
  const int yBase = yTopo + OLED_CABECALHO_TABELA_ALTURA;

  display.drawFastHLine(0, yBase, SCREEN_WIDTH, SSD1306_WHITE);
  display.drawFastVLine(OLED_CABECALHO_TABELA_DIVISOR_X, yTopo, yBase - yTopo, SSD1306_WHITE);

  display.setCursor(2, yTopo + 1);
  display.print(mostrarSeta ? ">Dispositivos" : " Dispositivos");

  display.setCursor(OLED_CABECALHO_TABELA_DIVISOR_X + 3, yTopo + 1);
  display.print(" Status");
}

// Lista rolável centrada no item selecionado.
void desenharConteudoConfiguracao() {
  desenharCabecalhoTabela(false);

  const int totalItens = 2 + TOTAL_RELES_MANUAIS; // modo de cultivo + luz manual + relés manuais
  const int visiveis = 4;
  const int yListaTopo = OLED_CONTEUDO_TOPO + OLED_CABECALHO_TABELA_ALTURA + 2;

  int indiceAtual;
  if (releSelecionadoControle == CONTROLE_MODO_CULTIVO) {
    indiceAtual = 0;
  } else if (releSelecionadoControle == CONTROLE_LUZ_MANUAL) {
    indiceAtual = 1;
  } else {
    indiceAtual = releParaItemIndex(releSelecionadoControle);
  }

  int inicio = indiceAtual - visiveis / 2;
  if (inicio < 0) inicio = 0;
  if (inicio > totalItens - visiveis) inicio = totalItens - visiveis;
  if (inicio < 0) inicio = 0;

  display.setTextSize(1);
  for (int linha = 0; linha < visiveis && (inicio + linha) < totalItens; linha++) {
    int idx = inicio + linha;
    int releIdx = itemIndexParaRele(idx);
    int y = yListaTopo + linha * 8;

    display.setCursor(0, y);
    display.print(idx == indiceAtual ? ">" : " ");

    if (releIdx == CONTROLE_MODO_CULTIVO) {
      display.print("Modo Cultivo");
      display.setCursor(SCREEN_WIDTH - 34, y);
      display.print(modoAtual == VEGETACAO ? "Vega" : "Flora");
    } else if (releIdx == CONTROLE_LUZ_MANUAL) {
      display.print("Luz Manual");
      display.setCursor(SCREEN_WIDTH - 28, y);
      display.print(textoModoControleLuz());
    } else {
      display.print(nomeReleControle(releIdx));
      display.setCursor(SCREEN_WIDTH - 22, y);
      display.print(estadoReles[releIdx] ? "ON" : "OFF");
    }
  }
}

// ---------- confirmação para abrir a configuração ----------
void desenharMenuOLED() {
  display.setTextSize(1);

  desenharCabecalhoTabela(true);

  const int yCaixaBase = OLED_CONTEUDO_TOPO + OLED_CABECALHO_TABELA_ALTURA;

  // Instrução, centralizada, abaixo da caixa
  const char* linha1 = "Segure";
  int16_t x1, y1;
  uint16_t w, h;
  display.getTextBounds(linha1, 0, 0, &x1, &y1, &w, &h);
  display.setCursor((SCREEN_WIDTH - (int)w) / 2, yCaixaBase + 12);
  display.print(linha1);

  const char* linha2 = "Para Abrir.";
  display.getTextBounds(linha2, 0, 0, &x1, &y1, &w, &h);
  display.setCursor((SCREEN_WIDTH - (int)w) / 2, yCaixaBase + 24);
  display.print(linha2);
}

// ---------- mensagem temporária (centralizada) ----------
void desenharMensagem() {
  display.setTextSize(1);
  int16_t x1, y1;
  uint16_t w, h;
  display.getTextBounds(linha1Mensagem, 0, 0, &x1, &y1, &w, &h);
  int centroY = OLED_CONTEUDO_TOPO + ((SCREEN_HEIGHT - OLED_CONTEUDO_TOPO) - (int)h) / 2;
  display.setCursor((SCREEN_WIDTH - (int)w) / 2, centroY);
  display.print(linha1Mensagem);
}

// ---------- tela de descanso: dados + sol/lua animados ----------
// A fonte padrão não tem acentos: textos do OLED sem acentuação; ° = char 248.

// Posição do ícone de sol/lua, na coluna direita, ao lado dos dados
const int OLED_DESCANSO_ICONE_CX = 104;
const int OLED_DESCANSO_ICONE_CY = 34;

// Luz ligada: sol pulsando com raios girando.
void desenharSol(int cx, int cy) {
  int r = 6;

  float t = millis() / 1000.0;

  float pulso = (sin(t * 2.0) + 1.0) / 2.0; // 0..1
  int raioNucleo = r + (int)(pulso * 2.0);

  display.fillCircle(cx, cy, raioNucleo, SSD1306_WHITE);

  float rotacao = t * 0.9;
  for (int i = 0; i < 8; i++) {
    float ang = rotacao + i * (PI / 4.0);
    float variacao = (sin(t * 3.0 + i) + 1.0) / 2.0; // 0..1, defasado por raio
    int comprimento = 2 + (int)(variacao * 3.0);

    int x1 = cx + cos(ang) * (raioNucleo + 2);
    int y1 = cy + sin(ang) * (raioNucleo + 2);
    int x2 = cx + cos(ang) * (raioNucleo + 2 + comprimento);
    int y2 = cy + sin(ang) * (raioNucleo + 2 + comprimento);
    display.drawLine(x1, y1, x2, y2, SSD1306_WHITE);
  }
}

// Luz desligada: lua flutuando.
void desenharLua(int cx, int cy) {
  int r = 9;

  float t = millis() / 1000.0;
  int deslocY = (int)(sin(t * 0.8) * 1.5);

  display.fillCircle(cx, cy + deslocY, r, SSD1306_WHITE);
  display.fillCircle(cx + 5, cy - 3 + deslocY, r - 3, SSD1306_BLACK);
}

void desenharTelaDescanso(const DateTime& now) {
  desenharCabecalho(now, "Cultivo");

  // --- Coluna de dados (esquerda) ---
  const int xDados = 0;
  const int espacoLinha = 11;
  int y = OLED_CONTEUDO_TOPO;

  display.setTextSize(1);

  display.setCursor(xDados, y);
  display.print("T: ");
  display.print(formatarTemperatura(tempAtual));
  // Grau 2px acima da linha do texto.
  int16_t grauX = display.getCursorX();
  int16_t grauY = display.getCursorY();
  display.setCursor(grauX, grauY - 2);
  display.write(248); // símbolo de grau
  display.setCursor(grauX + 6, grauY);
  display.print("C");
  y += espacoLinha;

  display.setCursor(xDados, y);
  display.print("U: ");
  if (isnan(umidAtual)) {
    display.print("--");
  } else {
    display.print(umidAtual, 0);
  }
  display.print("%");
  y += espacoLinha;

  display.setCursor(xDados, y);
  display.print("VPD: ");
  display.print(formatarVPD(calcularVPD(tempAtual, umidAtual)));
  y += espacoLinha;

  display.setCursor(xDados, y);
  display.print("S:");
  display.print(textoPercentual(soloValido, soloPercentual));
  display.print(" A:");  // caixa d'água
  display.print(textoPercentual(!isnan(aguaPercentual), aguaPercentual));

  // --- Ícone (direita): sol ou lua, conforme o estado real do relé de luz ---
  if (estadoReles[RELE_LUZ]) {
    desenharSol(OLED_DESCANSO_ICONE_CX, OLED_DESCANSO_ICONE_CY);
  } else {
    desenharLua(OLED_DESCANSO_ICONE_CX, OLED_DESCANSO_ICONE_CY);
  }

  // Tempo até a próxima troca da luz, ou do override manual ("LM: HHhMMm").
  String restante;
  if (modoControleLuz != LUZ_AUTOMATICA) {
    restante = "LM: " + tempoRestanteOverrideLuz();
  } else {
    restante = tempoRestante(now);
  }
  int16_t rx1, ry1;
  uint16_t rw, rh;
  display.getTextBounds(restante, 0, 0, &rx1, &ry1, &rw, &rh);
  int xTexto = OLED_DESCANSO_ICONE_CX - (int)rw / 2;
  if (xTexto + (int)rw > SCREEN_WIDTH - 1) {
    xTexto = SCREEN_WIDTH - 1 - (int)rw;
  }
  if (xTexto < 0) {
    xTexto = 0;
  }
  display.setCursor(xTexto, 54);
  display.print(restante);
}

// ---------- renderização ----------
// Único ponto que chama display.display(); só redesenha se atualizarOLED.
void renderizarOLED(const DateTime& now) {
  if (!atualizarOLED) return;
  atualizarOLED = false;

  display.clearDisplay();

  if (estadoOLED == OLED_DESCANSO) {
    desenharTelaDescanso(now);
    display.display();
    return;
  }

  const char* titulo = "CULTIVO";
  if (estadoOLED == OLED_EXIBINDO && telaSelecionada == TELA_PRINCIPAL) {
    titulo = "Informacoes";
  } else if (telaSelecionada == TELA_CONFIGURACAO) {
    titulo = "Config";
  }

  desenharCabecalho(now, titulo);

  switch (estadoOLED) {
    case OLED_MENSAGEM:
      desenharMensagem();
      break;
    case OLED_MENU:
      desenharMenuOLED();
      break;
    case OLED_EXIBINDO:
      switch (telaSelecionada) {
        case TELA_PRINCIPAL:
          desenharConteudoPrincipal();
          break;
        case TELA_CONFIGURACAO:
          desenharConteudoConfiguracao();
          break;
        default:
          break;
      }
      break;
    default:
      break;
  }

  display.display();
}

// =========================================================================

// ---------------- BUZZER ----------------
void beep(unsigned long tempo) {
  digitalWrite(BUZZER, HIGH);
  buzzerLigado = true;
  buzzerDesligaEm = millis() + tempo;
}

void atualizarBuzzer() {
  if (buzzerLigado && prazoVencido(buzzerDesligaEm)) {
    digitalWrite(BUZZER, LOW);
    buzzerLigado = false;
  }
}

// ---------------- RELÉS ----------------
// Único ponto que escreve nos pinos de relé (mantém estadoReles[] em sincronia).
void acionarRele(int numero, bool ligado) {
  estadoReles[numero] = ligado;
  int nivelAtivo = RELE_ATIVO_EM_BAIXO ? LOW : HIGH;
  int nivelInativo = RELE_ATIVO_EM_BAIXO ? HIGH : LOW;
  digitalWrite(reles[numero], ligado ? nivelAtivo : nivelInativo);
}

// Ciclo do menu: Modo Cultivo -> Luz Manual -> relés de RELES_MANUAIS.
void avancarReleControle() {
  if (releSelecionadoControle == CONTROLE_MODO_CULTIVO) {
    releSelecionadoControle = CONTROLE_LUZ_MANUAL;
  } else if (releSelecionadoControle == CONTROLE_LUZ_MANUAL) {
    releSelecionadoControle = RELES_MANUAIS[0];
  } else {
    int posAtual = releParaItemIndex(releSelecionadoControle) - 2;
    if (posAtual + 1 >= TOTAL_RELES_MANUAIS) {
      releSelecionadoControle = CONTROLE_MODO_CULTIVO;
    } else {
      releSelecionadoControle = RELES_MANUAIS[posAtual + 1];
    }
  }
  oledVoltaDescansoEm = millis() + TEMPO_EXIBICAO_OLED_MS;
  ultimaInteracaoMenuEm = millis();
  atualizarOLED = true;
}

// Clique longo: alterna o item selecionado (modo, luz ou relé).
void alternarReleSelecionado() {
  if (releSelecionadoControle == CONTROLE_MODO_CULTIVO) {
    alternarModoCultivo();
    return;
  }

  if (releSelecionadoControle == CONTROLE_LUZ_MANUAL) {
    alternarModoControleLuz();
    return;
  }

  if (releSelecionadoControle < PRIMEIRO_RELE_MANUAL || releSelecionadoControle >= TOTAL_RELES) {
    return;
  }

  bool novoEstado = !estadoReles[releSelecionadoControle];
  if (releSelecionadoControle == RELE_IRRIGACAO && novoEstado && irrigacaoBloqueadaPelaAgua()) {
    mostrarMensagemTemporaria("Caixa vazia", 1500);  // proteção da bomba
    registrarEventoRele(RELE_IRRIGACAO, false, "bloqueio_agua");
    return;
  }
  pausarClimaDoRele(releSelecionadoControle, "manual");
  acionarRele(releSelecionadoControle, novoEstado);
  registrarEventoRele(releSelecionadoControle, novoEstado, "manual");
  salvarEstadoNaMemoria();

  oledVoltaDescansoEm = millis() + TEMPO_EXIBICAO_OLED_MS;
  ultimaInteracaoMenuEm = millis();
  atualizarOLED = true;
}

// Ciclo do override: Automático -> Ligada -> Desligada.
void alternarModoControleLuz() {
  switch (modoControleLuz) {
    case LUZ_AUTOMATICA:
      modoControleLuz = LUZ_MANUAL_LIGADA;
      break;
    case LUZ_MANUAL_LIGADA:
      modoControleLuz = LUZ_MANUAL_DESLIGADA;
      break;
    case LUZ_MANUAL_DESLIGADA:
    default:
      modoControleLuz = LUZ_AUTOMATICA;
      break;
  }

  overrideLuzAte = (modoControleLuz == LUZ_AUTOMATICA) ? 0 : (millis() + duracaoOverrideLuzMs());

  const char* origem = (modoControleLuz == LUZ_AUTOMATICA) ? "retomou_automatico" : "override_manual";
  registrarEventoRele(RELE_LUZ, modoControleLuz == LUZ_MANUAL_LIGADA, origem);

  oledVoltaDescansoEm = millis() + TEMPO_EXIBICAO_OLED_MS;
  ultimaInteracaoMenuEm = millis();
  atualizarOLED = true;
  salvarEstadoNaMemoria();
}

// Versão do dashboard: define o modo direto, sem mexer nos timers do menu OLED.
void definirModoControleLuzRemoto(ModoControleLuz novoModo) {
  if (novoModo == modoControleLuz) return; // nada mudou, evita gravar/piscar à toa

  modoControleLuz = novoModo;
  overrideLuzAte = (modoControleLuz == LUZ_AUTOMATICA) ? 0 : (millis() + duracaoOverrideLuzMs());

  const char* origem = (modoControleLuz == LUZ_AUTOMATICA) ? "retomou_automatico" : "override_manual";
  registrarEventoRele(RELE_LUZ, modoControleLuz == LUZ_MANUAL_LIGADA, origem);

  atualizarOLED = true;
  salvarEstadoNaMemoria();
}

// Nomes exibidos no OLED e enviados à Hostinger (o dashboard usa os mesmos).
const char* nomeReleControle(int indiceRele) {
  switch (indiceRele) {
    case 0:
      return "Luz";
    case 1:
      return "Irrigacao";
    case 2:
      return "Ventilador";
    case 3:
      return "Umidificador";
    case 4:
      return "Entrada de Ar";
    case 5:
      return "Aquecedor";
    case 6:
      return "Trava Acesso";
    case 7:
      return "Saida de Ar";
    default:
      return "Rele";
  }
}

// Alterna entre vegetação e floração (muda a janela de luz).
void alternarModoCultivo() {
  if (modoAtual == VEGETACAO) {
    modoAtual = FLORACAO;
    mostrarMensagemTemporaria("Modo: Floracao", 1500);
    registrarEventoModo("floracao", "manual");
    registrarEventoFotoperiodo(FLORACAO, "manual");
  } else {
    modoAtual = VEGETACAO;
    mostrarMensagemTemporaria("Modo: Vegetativo", 1500);
    registrarEventoModo("vegetativo", "manual");
    registrarEventoFotoperiodo(VEGETACAO, "manual");
  }

  oledVoltaDescansoEm = millis() + TEMPO_EXIBICAO_OLED_MS;
  ultimaInteracaoMenuEm = millis();
  atualizarOLED = true;
  salvarEstadoNaMemoria();
}

// Versão do dashboard: define o modo direto.
void definirModoCultivoRemoto(ModoCultivo novoModo) {
  if (novoModo == modoAtual) return; // nada mudou, evita gravar/piscar à toa

  modoAtual = novoModo;
  mostrarMensagemTemporaria(modoAtual == FLORACAO ? "Modo: Floracao" : "Modo: Vegetativo", 1500);
  registrarEventoModo(modoAtual == FLORACAO ? "floracao" : "vegetativo", "web");
  registrarEventoFotoperiodo(modoAtual, "web"); // confirma ao painel o timer em uso na nova fase
  atualizarOLED = true;
  salvarEstadoNaMemoria();
}

// Pulso na trava; atualizarAcesso() fecha quando expira.
void liberarAcessoPor(unsigned long duracaoMs) {
  acionarRele(RELE_ACESSO, true);
  acessoAtivo = true;
  acessoDesligaEm = millis() + duracaoMs;
  atualizarOLED = true;
}

void liberarAcessoRemoto() {
  liberarAcessoPor(3000);
  beep(150);
  mostrarMensagemTemporaria("Porta Liberada", 1500);
  registrarEventoAcesso("web", "liberado");
}

void atualizarAcesso() {
  if (acessoAtivo && prazoVencido(acessoDesligaEm)) {
    acionarRele(RELE_ACESSO, false);
    acessoAtivo = false;
    atualizarOLED = true;
  }
}

// ---------------- PERSISTÊNCIA (NVRAM DO RTC DS1307) ----------------
// [0] marcador  [1] bitmask relés manuais  [2] modo  [3] override luz
// [4..7] expiração do override em unixtime (millis() zera no boot).
// Marcador 0xA6: umidificador no relé 3 e irrigação no relé 1 (firmware 2.6.3).
// Marcador 0xA5: layout antigo (umidificador no 1, irrigação no 3) -> convertido ao ler.
const uint8_t NVRAM_MARCADOR_VALIDO = 0xA6;
const uint8_t NVRAM_MARCADOR_ANTIGO = 0xA5;
const uint8_t NVRAM_ENDERECO_BASE = 0;
const uint8_t NVRAM_TAMANHO = 8;

const uint8_t NVRAM_MODO_LUZ_AUTO = 0;
const uint8_t NVRAM_MODO_LUZ_LIGADA = 1;
const uint8_t NVRAM_MODO_LUZ_DESLIGADA = 2;

// ---------------- PERSISTÊNCIA EM DOIS LUGARES ----------------
// A memória do DS1307 só se mantém com a bateria do módulo: sem ela, uma falta de energia
// apagava relés, fase e horários de luz. Por isso cada bloco vai também para a flash do ESP32
// (NVS "estado"), que não depende de bateria. A flash só é gravada quando o conteúdo muda.
void gravarBlocoEstado(const char* chave, uint8_t endereco, const uint8_t* buffer, size_t tamanho) {
  if (rtcDisponivel) rtc.writenvram(endereco, (uint8_t*)buffer, tamanho);
  Preferences p;
  if (!p.begin("estado", false)) return;
  uint8_t atual[16];
  bool igual = tamanho <= sizeof(atual) && p.getBytesLength(chave) == tamanho &&
               p.getBytes(chave, atual, tamanho) == tamanho && memcmp(atual, buffer, tamanho) == 0;
  if (!igual) p.putBytes(chave, buffer, tamanho);
  p.end();
}

// Lê da flash; se ainda não houver cópia (primeiro boot depois de atualizar), da memória do RTC.
bool lerBlocoEstado(const char* chave, uint8_t endereco, uint8_t* buffer, size_t tamanho, const char*& origem) {
  Preferences p;
  if (p.begin("estado", true)) {
    bool ok = p.getBytesLength(chave) == tamanho && p.getBytes(chave, buffer, tamanho) == tamanho;
    p.end();
    if (ok) {
      origem = "flash";
      return true;
    }
  }
  if (!rtcDisponivel) return false;
  rtc.readnvram(buffer, tamanho, endereco);
  origem = "RTC";
  return true;
}

// Último estado da luz (para o boot não apagar a luz enquanto a hora não é conhecida).
bool lerLuzSalva() {
  Preferences p;
  if (!p.begin("estado", true)) return false;
  bool ligada = p.getUChar("luz", 0) == 1;
  p.end();
  return ligada;
}

void salvarLuz(bool ligada) {
  Preferences p;
  if (!p.begin("estado", false)) return;
  if (p.getUChar("luz", 255) != (ligada ? 1 : 0)) p.putUChar("luz", ligada ? 1 : 0);
  p.end();
}

// Hora em que dá para confiar: NTP ou RTC que não parou.
bool horaConfiavel() {
  return horaSincronizada || (rtcDisponivel && !rtcPerdeuHora);
}

void salvarEstadoNaMemoria() {

  uint8_t bitmaskReles = 0;
  for (int i = 0; i < TOTAL_RELES; i++) {
    // Luz e trava não são restauradas.
    if (i == RELE_LUZ || i == RELE_ACESSO) continue;
    if (estadoReles[i]) {
      bitmaskReles |= (1 << i);
    }
  }

  uint8_t modoLuzByte = NVRAM_MODO_LUZ_AUTO;
  uint32_t expiraUnix = 0;
  if (modoControleLuz != LUZ_AUTOMATICA) {
    modoLuzByte = (modoControleLuz == LUZ_MANUAL_LIGADA) ? NVRAM_MODO_LUZ_LIGADA : NVRAM_MODO_LUZ_DESLIGADA;
    unsigned long restanteMs = msAtePrazo(overrideLuzAte);
    expiraUnix = obterAgora().unixtime() + (restanteMs / 1000UL);
  }

  uint8_t buffer[NVRAM_TAMANHO];
  buffer[0] = NVRAM_MARCADOR_VALIDO;
  buffer[1] = bitmaskReles;
  buffer[2] = (modoAtual == FLORACAO) ? 1 : 0;
  buffer[3] = modoLuzByte;
  buffer[4] = (uint8_t)(expiraUnix >> 24);
  buffer[5] = (uint8_t)(expiraUnix >> 16);
  buffer[6] = (uint8_t)(expiraUnix >> 8);
  buffer[7] = (uint8_t)(expiraUnix);

  gravarBlocoEstado("reles", NVRAM_ENDERECO_BASE, buffer, NVRAM_TAMANHO);
}

void restaurarEstadoDaMemoria() {
  uint8_t buffer[NVRAM_TAMANHO];
  const char* origem = "";
  if (!lerBlocoEstado("reles", NVRAM_ENDERECO_BASE, buffer, NVRAM_TAMANHO, origem)) {
    Serial.println("Sem estado salvo (nem flash nem RTC) - mantendo padroes de fabrica");
    return;
  }

  Serial.printf("Estado lido da %s - ", origem);
  Serial.print("marcador=0x");
  Serial.print(buffer[0], HEX);
  Serial.print(" bitmask=0x");
  Serial.print(buffer[1], HEX);
  Serial.print(" modoCultivo=");
  Serial.print(buffer[2]);
  Serial.print(" modoLuz=");
  Serial.print(buffer[3]);
  Serial.print(" expiraUnix=");
  Serial.println(((uint32_t)buffer[4] << 24) | ((uint32_t)buffer[5] << 16) |
                  ((uint32_t)buffer[6] << 8) | (uint32_t)buffer[7]);

  uint8_t bitmaskReles = buffer[1];
  if (buffer[0] == NVRAM_MARCADOR_ANTIGO) {
    // Layout antigo: troca os bits 1 e 3 para o umidificador não voltar como irrigação (e vice-versa).
    bool bit1 = bitmaskReles & (1 << 1);
    bool bit3 = bitmaskReles & (1 << 3);
    bitmaskReles &= ~((1 << 1) | (1 << 3));
    if (bit1) bitmaskReles |= (1 << 3);
    if (bit3) bitmaskReles |= (1 << 1);
    Serial.println("NVRAM no layout antigo - reles 1 e 3 convertidos (umidificador agora no rele 3)");
  } else if (buffer[0] != NVRAM_MARCADOR_VALIDO) {
    Serial.println("NVRAM sem marcador valido - mantendo padroes de fabrica "
                   "(memoria do RTC zerada? confira a bateria do modulo do relogio)");
    return;
  }

  modoAtual = (buffer[2] == 1) ? FLORACAO : VEGETACAO;

  // Restaura só os relés manuais; a trava nunca volta ligada.
  for (int i = 0; i < TOTAL_RELES_MANUAIS; i++) {
    int idx = RELES_MANUAIS[i];
    bool ligado = bitmaskReles & (1 << idx);
    acionarRele(idx, ligado);
  }

  // Restaura o override se ainda não expirou; valida o byte contra lixo antigo.
  uint8_t modoLuzByte = buffer[3];
  bool modoLuzValido = (modoLuzByte == NVRAM_MODO_LUZ_AUTO ||
                         modoLuzByte == NVRAM_MODO_LUZ_LIGADA ||
                         modoLuzByte == NVRAM_MODO_LUZ_DESLIGADA);

  if (!modoLuzValido) {
    Serial.println("Byte de modoLuz invalido na NVRAM (dado antigo/residual) - mantendo automatico");
  } else if (modoLuzByte != NVRAM_MODO_LUZ_AUTO) {
    uint32_t expiraUnix = ((uint32_t)buffer[4] << 24) | ((uint32_t)buffer[5] << 16) |
                           ((uint32_t)buffer[6] << 8) | (uint32_t)buffer[7];
    uint32_t agoraUnix = obterAgora().unixtime();

    if (expiraUnix > agoraUnix) {
      // Limita ao maior tempo possível do modo manual: se o RTC perdeu a hora (sem bateria),
      // "agora" é a hora da compilação e a diferença pode passar de dias.
      uint32_t restanteSeg = min(expiraUnix - agoraUnix, (uint32_t)(DURACAO_LUZ_MANUAL_MAX_MIN * 60UL));
      modoControleLuz = (modoLuzByte == NVRAM_MODO_LUZ_LIGADA) ? LUZ_MANUAL_LIGADA : LUZ_MANUAL_DESLIGADA;
      overrideLuzAte = millis() + restanteSeg * 1000UL;
      Serial.println("Override manual da luz restaurado da NVRAM (ainda nao expirou)");
    } else {
      Serial.println("Override manual da luz tinha expirado durante o desligamento - mantendo automatico");
    }
  }

  Serial.println("Estado dos reles e modo de cultivo restaurados");
  atualizarOLED = true;
}

// Ao ligar, informa ao painel o estado real de cada relé manual (restaurado da memória do RTC
// ou desligado, se não havia memória). Sem isso, depois de um reinício ou de uma queda de energia
// o relé voltava ligado (ou desligado) e o servidor continuava com o estado antigo.
void registrarEstadoInicialReles() {
  for (int i = 0; i < TOTAL_RELES_MANUAIS; i++) {
    int idx = RELES_MANUAIS[i];
    registrarEventoRele(idx, estadoReles[idx], "boot");
  }
}

// Fotoperíodo: bloco próprio com marcador (versões antigas caem no padrão).
//   [8] 0x5B  [9..10] início veg (min)  [11..12] início flora (min)
const uint8_t NVRAM_FOTO_ENDERECO = 8;
const uint8_t NVRAM_FOTO_TAMANHO = 5;
const uint8_t NVRAM_FOTO_MARCADOR = 0x5B;

bool inicioLuzValido(int minutos) {
  return minutos >= 0 && minutos < 24 * 60;
}

void salvarFotoperiodoNaMemoria() {
  uint8_t buffer[NVRAM_FOTO_TAMANHO];
  buffer[0] = NVRAM_FOTO_MARCADOR;
  buffer[1] = (uint8_t)(inicioLuzVegetacaoMin >> 8);
  buffer[2] = (uint8_t)(inicioLuzVegetacaoMin & 0xFF);
  buffer[3] = (uint8_t)(inicioLuzFloracaoMin >> 8);
  buffer[4] = (uint8_t)(inicioLuzFloracaoMin & 0xFF);
  gravarBlocoEstado("foto", NVRAM_FOTO_ENDERECO, buffer, NVRAM_FOTO_TAMANHO);
}

void restaurarFotoperiodoDaMemoria() {
  uint8_t buffer[NVRAM_FOTO_TAMANHO];
  const char* origem = "";
  if (!lerBlocoEstado("foto", NVRAM_FOTO_ENDERECO, buffer, NVRAM_FOTO_TAMANHO, origem) ||
      buffer[0] != NVRAM_FOTO_MARCADOR) {
    Serial.println("NVRAM sem fotoperiodo salvo - usando horarios padrao (16h veg / 19h flora)");
    return;
  }
  int veg = ((int)buffer[1] << 8) | buffer[2];
  int flora = ((int)buffer[3] << 8) | buffer[4];
  if (inicioLuzValido(veg)) inicioLuzVegetacaoMin = veg;
  if (inicioLuzValido(flora)) inicioLuzFloracaoMin = flora;
  Serial.printf("Fotoperiodo restaurado da %s: veg inicia %02d:%02d, flora inicia %02d:%02d\n", origem,
                inicioLuzVegetacaoMin / 60, inicioLuzVegetacaoMin % 60,
                inicioLuzFloracaoMin / 60, inicioLuzFloracaoMin % 60);
}

// Duração do modo manual da luz: [13] 0x6C  [14] minutos.
const uint8_t NVRAM_LUZ_ENDERECO = 13;
const uint8_t NVRAM_LUZ_MARCADOR = 0x6C;

bool duracaoLuzValida(int minutos) {
  // Opções do painel: 15, 30, 60 ou DURACAO_LUZ_MANUAL_MAX_MIN (120).
  return minutos == 15 || minutos == 30 || minutos == 60 || minutos == 120;
}

void salvarDuracaoLuzNaMemoria() {
  uint8_t buffer[2] = { NVRAM_LUZ_MARCADOR, (uint8_t)duracaoOverrideLuzMin };
  gravarBlocoEstado("luzdur", NVRAM_LUZ_ENDERECO, buffer, 2);
}

void restaurarDuracaoLuzDaMemoria() {
  uint8_t buffer[2];
  const char* origem = "";
  if (lerBlocoEstado("luzdur", NVRAM_LUZ_ENDERECO, buffer, 2, origem) &&
      buffer[0] == NVRAM_LUZ_MARCADOR && duracaoLuzValida(buffer[1])) {
    duracaoOverrideLuzMin = buffer[1];
  }
  Serial.printf("Modo manual da luz: %d min\n", duracaoOverrideLuzMin);
}

// Confirma ao painel a duração em uso (ao ligar e após cada comando).
void registrarEventoDuracaoLuz(const char* origem) {
  enfileirarComandoHostinger("luz_duracao", "Luz", String(duracaoOverrideLuzMin), origem);
}

void definirDuracaoLuzRemoto(int minutos) {
  if (!duracaoLuzValida(minutos)) {
    Serial.printf("Hostinger: duracao do modo manual invalida: %d\n", minutos);
    return;
  }
  if (minutos != duracaoOverrideLuzMin) {
    duracaoOverrideLuzMin = minutos;
    salvarDuracaoLuzNaMemoria();
    // Um manual já ativo passa a valer pela nova duração, contada a partir de agora.
    if (modoControleLuz != LUZ_AUTOMATICA) overrideLuzAte = millis() + duracaoOverrideLuzMs();
  }
  registrarEventoDuracaoLuz("web");
}

// ---------------- CLIMA POR VPD (só o umidificador) ----------------
// Roda no próprio ESP32 (funciona sem internet). O usuário escolhe a fase do clima
// (muda, vegetação ou floração) e a faixa de VPD dela. Só o umidificador age, usando a faixa inteira:
//   o VPD deve ficar SEMPRE dentro da faixa, então o umidificador age antes das bordas:
//   liga no "ponto de ligar" (25% da largura abaixo do máximo; faixa 1,20–1,60 -> 1,50),
//   umidifica até o "ponto de desligar" (25% acima do mínimo -> 1,30) e desliga;
//   fica desligado até o VPD voltar ao ponto de ligar.
//   A 10% de cada borda (1,56 / 1,24) age na hora, sem confirmação nem tempo mínimo:
//   perto do máximo liga imediatamente (prioridade); perto do mínimo só espera 1 min desde a última troca.
// O aquecedor NÃO participa (é um relé comum, só manual).
// Trava: o umidificador nunca passa de travaUmid % (travaTemp segue no comando só por compatibilidade).
//
// Contra o liga/desliga curto (névoa do umidificador batendo no sensor, estufa pequena):
//   - o controle usa a média dos últimos 60 s (12 amostras a cada 5 s) descartando os 2 valores
//     mais altos e os 2 mais baixos, então picos curtos de névoa no sensor não contam;
//   - a condição precisa se manter por 30 s seguidos antes de ligar ou desligar;
//   - o umidificador fica no mínimo minLigado minutos ligado e minDesligado minutos desligado.
//   A trava e a falta de sensor desligam na hora (segurança), sem esperar esses tempos.
// Cada ação manda ao painel um evento "clima_leitura" com a leitura e o motivo.
//
// Comando do painel: tipo "clima_vpd", alvo "clima",
//   valor "ativa;fase;min;max;travaTemp;travaUmid;minLigado;minDesligado"
//   ex.: "1;2;1.20;1.60;28.0;60;3;3" (fase: 0 muda, 1 vegetação, 2 floração; tempos em minutos).
//   O formato antigo, sem os dois tempos, também é aceito (usa 3 e 3 min).
// Um comando manual no umidificador (painel ou OLED) pausa o clima.
struct ClimaVpd {
  bool ativa;
  int fase;
  float min;
  float max;
  float travaTemp;
  float travaUmid;
  int minLigado;     // minutos
  int minDesligado;  // minutos
};
ClimaVpd clima = { false, 2, 1.20f, 1.60f, 28.0f, 60.0f, 3, 3 };
const char* NOMES_FASE_CLIMA[] = { "muda", "vegetacao", "floracao" };
const unsigned long INTERVALO_CLIMA_MS = 5000;     // amostra e avalia a cada 5 s
const int AMOSTRAS_MEDIA_CLIMA = 12;               // 12 x 5 s = média de 60 s
const int AMOSTRAS_MINIMAS_CLIMA = 6;              // precisa de 30 s de leitura para agir
const unsigned long CONFIRMACAO_CLIMA_MS = 30000;  // condição sustentada por 30 s
const float FOLGA_TRAVA_UMID = 2.0f;  // só volta a ligar o umidificador 2% abaixo da trava
// O VPD deve ficar SEMPRE dentro da faixa. Por isso o umidificador age antes das bordas:
//   liga a 25% da largura abaixo do máximo e desliga a 25% acima do mínimo
//   (ex.: faixa 1,20–1,60 → liga em 1,50 e desliga em 1,30);
//   a 10% de cada borda (1,56 / 1,24) age na hora, sem confirmação nem tempo mínimo.
const float MARGEM_ACAO_FRACAO = 0.25f;
const float MARGEM_URGENTE_FRACAO = 0.10f;
const unsigned long INTERVALO_MINIMO_PISO_MS = 60000;  // perto do mínimo: ainda espera 1 min desde a última troca
unsigned long ultimaAvaliacaoClimaEm = 0;

float amostrasTempClima[AMOSTRAS_MEDIA_CLIMA];
float amostrasUmidClima[AMOSTRAS_MEDIA_CLIMA];
int proximaAmostraClima = 0;
bool amostrasClimaIniciadas = false;

// Estado de controle de cada relé do clima.
struct ControleClima {
  int rele;
  unsigned long mudouEm;      // quando o relé mudou de estado (0 = desconhecido, ex.: depois de ligar o ESP32)
  bool ultimoEstado;
  bool pedido;                // estado pedido aguardando confirmação
  unsigned long pedidoDesde;  // 0 = nenhum pedido
};
ControleClima ctlUmidificador = { RELE_UMIDIFICADOR, 0, false, false, 0 };

String valorClima(const ClimaVpd& c) {
  return String(c.ativa ? 1 : 0) + ";" + String(c.fase) + ";" + String(c.min, 2) + ";" + String(c.max, 2) + ";" +
         String(c.travaTemp, 1) + ";" + String((int)roundf(c.travaUmid)) + ";" + String(c.minLigado) + ";" + String(c.minDesligado);
}

void registrarEventoClima(const char* origem) {
  enfileirarComandoHostinger("clima_vpd", "clima", valorClima(clima), origem);
}

void salvarClima() {
  Preferences p;
  p.begin("clima", false);
  p.putString("cfg", valorClima(clima));
  p.end();
}

// Lê "ativa;fase;min;max;travaTemp;travaUmid[;minLigado;minDesligado]"; false se inválido.
bool interpretarValorClima(const String& valor, ClimaVpd& saida) {
  int at = -1, fase = -1, mLig = 3, mDes = 3;
  float mn = NAN, mx = NAN, tt = NAN, tu = NAN;
  int lidos = sscanf(valor.c_str(), "%d;%d;%f;%f;%f;%f;%d;%d", &at, &fase, &mn, &mx, &tt, &tu, &mLig, &mDes);
  if (lidos != 6 && lidos != 8) return false;
  if ((at != 0 && at != 1) || fase < 0 || fase > 2) return false;
  if (isnan(mn) || isnan(mx) || mn < 0.2f || mx > 2.5f || mx - mn < 0.1f) return false;
  if (isnan(tt) || tt < 15.0f || tt > 40.0f || isnan(tu) || tu < 30.0f || tu > 95.0f) return false;
  if (mLig < 1 || mLig > 15 || mDes < 1 || mDes > 15) return false;
  saida = { at == 1, fase, mn, mx, tt, tu, mLig, mDes };
  return true;
}

void restaurarClima() {
  Preferences p;
  p.begin("clima", true);
  String salvo = p.getString("cfg", "");
  p.end();
  ClimaVpd lido;
  if (salvo.length() > 0 && interpretarValorClima(salvo, lido)) clima = lido;

  // Uma vez só, ao atualizar para o 2.7.2: o aquecedor deixou de ser controlado pelo clima.
  // Se ele estava ligado pela versão anterior, desliga para não ficar ligado indefinidamente.
  Preferences pm;
  pm.begin("clima", false);
  if (!pm.getBool("aq_fora", false)) {
    if (estadoReles[RELE_AQUECEDOR]) {
      acionarRele(RELE_AQUECEDOR, false);
      salvarEstadoNaMemoria();
      Serial.println("Clima por VPD sem aquecedor: aquecedor desligado uma vez na atualizacao");
    }
    pm.putBool("aq_fora", true);
  }
  pm.end();
  Serial.printf("Clima por VPD: %s, fase %s, %.2f-%.2f kPa, travas %.1f C / %.0f%%, minimo %d/%d min\n",
                clima.ativa ? "ativo" : "desativado", NOMES_FASE_CLIMA[clima.fase], clima.min, clima.max,
                clima.travaTemp, clima.travaUmid, clima.minLigado, clima.minDesligado);
}

void definirClimaRemoto(const String& valor) {
  ClimaVpd novo;
  if (!interpretarValorClima(valor, novo)) {
    Serial.println("Hostinger: clima_vpd invalido: " + valor);
    return;
  }
  clima = novo;
  ctlUmidificador.pedidoDesde = 0;   // pedido pendente recomeça com a configuração nova
  ultimaAvaliacaoClimaEm = 0;
  salvarClima();
  registrarEventoClima("web");
  // Ao desativar, os relés ficam como estão; o usuário decide pelos interruptores.
  atualizarOLED = true;
}

// Comando manual no umidificador: o clima pausa (o comando manual vale). O aquecedor não pausa nada.
void pausarClimaDoRele(int indiceRele, const char* origem) {
  if (!clima.ativa || indiceRele != RELE_UMIDIFICADOR) return;
  clima.ativa = false;
  salvarClima();
  // "pausa_*" diferencia a pausa por comando manual da desativação pelo painel.
  registrarEventoClima(strcmp(origem, "manual") == 0 ? "pausa_oled" : "pausa_painel");
  Serial.println("Clima por VPD pausado por comando manual");
}

// Média sem os extremos: ordena e descarta os 2 maiores e os 2 menores (com 8 ou mais amostras).
float mediaSemExtremos(float* valores, int n) {
  for (int i = 1; i < n; i++) {  // ordenação por inserção (n <= 12)
    float v = valores[i];
    int j = i - 1;
    while (j >= 0 && valores[j] > v) { valores[j + 1] = valores[j]; j--; }
    valores[j + 1] = v;
  }
  int corte = n >= 8 ? 2 : 0;
  float soma = 0;
  for (int i = corte; i < n - corte; i++) soma += valores[i];
  return soma / (n - 2 * corte);
}

// Guarda a leitura instantânea e devolve a média dos últimos 60 s sem os extremos.
void amostrarClima(float& tempMedia, float& umidMedia, int& validas) {
  if (!amostrasClimaIniciadas) {
    for (int i = 0; i < AMOSTRAS_MEDIA_CLIMA; i++) { amostrasTempClima[i] = NAN; amostrasUmidClima[i] = NAN; }
    amostrasClimaIniciadas = true;
  }
  amostrasTempClima[proximaAmostraClima] = tempAtual;
  amostrasUmidClima[proximaAmostraClima] = umidAtual;
  proximaAmostraClima = (proximaAmostraClima + 1) % AMOSTRAS_MEDIA_CLIMA;
  float t[AMOSTRAS_MEDIA_CLIMA], u[AMOSTRAS_MEDIA_CLIMA];
  validas = 0;
  for (int i = 0; i < AMOSTRAS_MEDIA_CLIMA; i++) {
    if (isnan(amostrasTempClima[i]) || isnan(amostrasUmidClima[i])) continue;
    t[validas] = amostrasTempClima[i];
    u[validas] = amostrasUmidClima[i];
    validas++;
  }
  tempMedia = validas > 0 ? mediaSemExtremos(t, validas) : NAN;
  umidMedia = validas > 0 ? mediaSemExtremos(u, validas) : NAN;
}

// Liga/desliga o relé e avisa o painel com a leitura (média) e o motivo da ação.
void executarAcaoClima(ControleClima& ctl, bool ligar, const char* motivo, float vpd, float temp, float umid) {
  String leitura = String(ligar ? 1 : 0) + ";" + (isnan(vpd) ? String("") : String(vpd, 2)) + ";" +
                   (isnan(temp) ? String("") : String(temp, 1)) + ";" + (isnan(umid) ? String("") : String(umid, 0)) + ";" + motivo;
  enfileirarComandoHostinger("clima_leitura", nomeReleControle(ctl.rele), leitura, "automacao");
  acionarRele(ctl.rele, ligar);
  registrarEventoRele(ctl.rele, ligar, "automacao");
  salvarEstadoNaMemoria();
  ctl.mudouEm = millis();
  ctl.ultimoEstado = ligar;
  ctl.pedidoDesde = 0;
  atualizarOLED = true;
}

// Decide se o pedido vira ação: segurança age na hora; o resto precisa de confirmação e do tempo mínimo.
// urgente: o VPD está quase saindo da faixa; age sem esperar a confirmação nem o tempo mínimo.
void decidirClima(ControleClima& ctl, bool desejado, bool seguranca, const char* motivo, float vpd, float temp, float umid, bool urgente = false) {
  bool atual = estadoReles[ctl.rele];
  if (desejado == atual) { ctl.pedidoDesde = 0; return; }
  if (seguranca && !desejado) { executarAcaoClima(ctl, false, motivo, vpd, temp, umid); return; }
  if (urgente) {
    // Perto do máximo liga na hora (prioridade: nunca passar do máximo).
    // Perto do mínimo espera 1 min desde a última troca, para não picotar o aparelho.
    if (desejado || ctl.mudouEm == 0 || millis() - ctl.mudouEm >= INTERVALO_MINIMO_PISO_MS) executarAcaoClima(ctl, desejado, motivo, vpd, temp, umid);
    return;
  }

  if (ctl.pedidoDesde == 0 || ctl.pedido != desejado) {  // novo pedido: começa a confirmar
    ctl.pedido = desejado;
    ctl.pedidoDesde = millis();
    return;
  }
  if (millis() - ctl.pedidoDesde < CONFIRMACAO_CLIMA_MS) return;

  unsigned long minimo = (unsigned long)(atual ? clima.minLigado : clima.minDesligado) * 60000UL;
  if (ctl.mudouEm != 0 && millis() - ctl.mudouEm < minimo) return;  // ainda dentro do tempo mínimo

  executarAcaoClima(ctl, desejado, motivo, vpd, temp, umid);
}

// Mudança feita fora do clima (comando manual, restauração ao ligar): reinicia o tempo mínimo a partir dela.
void acompanharMudancaExterna(ControleClima& ctl) {
  bool estado = estadoReles[ctl.rele];
  if (estado != ctl.ultimoEstado) {
    ctl.ultimoEstado = estado;
    ctl.mudouEm = millis();
    ctl.pedidoDesde = 0;
  }
}

void atualizarClima() {
  if (ultimaAvaliacaoClimaEm != 0 && millis() - ultimaAvaliacaoClimaEm < INTERVALO_CLIMA_MS) return;
  ultimaAvaliacaoClimaEm = millis();

  float temp, umid;
  int validas;
  amostrarClima(temp, umid, validas);  // amostra sempre, mesmo desativado, para a média estar pronta
  acompanharMudancaExterna(ctlUmidificador);
  if (!clima.ativa) return;

  // Sem leitura do sensor: por segurança desliga na hora.
  if (isnan(tempAtual) || isnan(umidAtual) || validas == 0) {
    decidirClima(ctlUmidificador, false, true, "sem_sensor", NAN, NAN, NAN);
    return;
  }
  if (validas < AMOSTRAS_MINIMAS_CLIMA) return;  // média ainda se formando (primeiros 30 s)

  float vpd = calcularVPD(temp, umid);

  // Umidificador: liga no ponto de ligar e desliga no ponto de desligar, os dois dentro da faixa.
  // Perto do máximo usa também a leitura instantânea: a névoa no sensor só faz o VPD parecer
  // MAIS BAIXO, então ela nunca liga à toa e reage antes da média de 60 s.
  // Perto do mínimo usa só a média, para um pico de névoa no sensor não desligar à toa.
  float largura = clima.max - clima.min;
  float ligaEm = clima.max - largura * MARGEM_ACAO_FRACAO;
  float desligaEm = clima.min + largura * MARGEM_ACAO_FRACAO;
  float tetoUrgente = clima.max - largura * MARGEM_URGENTE_FRACAO;
  float pisoUrgente = clima.min + largura * MARGEM_URGENTE_FRACAO;
  float vpdAgora = calcularVPD(tempAtual, umidAtual);
  float vpdTeto = (vpdAgora > vpd) ? vpdAgora : vpd;
  bool umidificador = estadoReles[RELE_UMIDIFICADOR];
  bool deseja = umidificador, seguranca = false, urgente = false;
  const char* motivo = "ponto_desligar";
  bool podeUmidificar = umid < clima.travaUmid - FOLGA_TRAVA_UMID && umidAtual < clima.travaUmid - FOLGA_TRAVA_UMID;
  if (umid >= clima.travaUmid) { deseja = false; seguranca = true; motivo = "trava_umid"; }
  else if (vpdTeto >= tetoUrgente && podeUmidificar) { deseja = true; urgente = true; motivo = "teto"; vpd = vpdTeto; }
  else if (vpd >= ligaEm && podeUmidificar) { deseja = true; motivo = "ponto_ligar"; }
  else if (vpd <= pisoUrgente) { deseja = false; urgente = true; motivo = "piso"; }
  else if (vpd <= desligaEm) { deseja = false; motivo = "ponto_desligar"; }

  decidirClima(ctlUmidificador, deseja, seguranca && !deseja, motivo, vpd, temp, umid, urgente);
}

// ---------------- CONFIGURAÇÃO DE REDE (NVS + portal) ----------------
// Token do hardware (sd_hw_...) se houver; senão a API_KEY do secrets.h (modo legado).
const char* chaveServidor() {
  return cfgToken.length() > 0 ? cfgToken.c_str() : SECRET_HOSTINGER_API_KEY;
}

void carregarConfigRede() {
  prefs.begin("sdemetra", true);
  cfgSsid = prefs.getString("ssid", SECRET_WIFI_SSID);
  cfgSenha = prefs.getString("senha", SECRET_WIFI_PASSWORD);
  cfgUrl = prefs.getString("url", SECRET_HOSTINGER_BASE_URL);
  cfgToken = prefs.getString("token", "");
  cfgVinculo = prefs.getString("vinculo", "");
  prefs.end();
  while (cfgUrl.endsWith("/")) cfgUrl.remove(cfgUrl.length() - 1);
}

// Usa um Preferences local: também é chamada pela tarefa de rede (vínculo).
void salvarConfigRede(const char* chave, const String& valor) {
  Preferences p;
  p.begin("sdemetra", false);
  if (valor.length() > 0) p.putString(chave, valor);
  else p.remove(chave);
  p.end();
}

bool redeConfigurada() {
  return cfgSsid.length() > 0 && cfgSsid != "SUA_REDE_WIFI";
}

// Botão do OLED pressionado por 3 s durante a inicialização abre o portal.
bool botaoPortalPressionado() {
  if (digitalRead(BOTAO_OLED_PIN) != LOW) return false;
  mensagemInicializacao("Solte para", "configurar Wi-Fi");
  unsigned long inicio = millis();
  while (digitalRead(BOTAO_OLED_PIN) == LOW) {
    if (millis() - inicio >= BOTAO_PORTAL_MS) return true;
    delay(20);
  }
  return false;
}

// Portal de configuração (bloqueante, até 5 min). Grava o que foi preenchido.
void abrirPortalConfiguracao() {
  mensagemInicializacao("SmartDemetra-Setup", "Abra 192.168.4.1");
  WiFiManager wm;
  wm.setTitle("Smart Demetra");
  wm.setConfigPortalTimeout(PORTAL_TIMEOUT_S);
  wm.setConnectTimeout(20);
  wm.setBreakAfterConfig(true); // grava os campos mesmo se a rede não conectar
  WiFiManagerParameter campoUrl("url", "Endereço do painel (https://...)", cfgUrl.c_str(), 120);
  WiFiManagerParameter campoToken("token", "Token de vinculação (ou token sd_hw_)", "", 60);
  wm.addParameter(&campoUrl);
  wm.addParameter(&campoToken);

  bool salvou = false;
  wm.setSaveConfigCallback([&salvou]() { salvou = true; });
  wm.startConfigPortal(PORTAL_SSID);
  if (!salvou) {
    Serial.println("Portal fechado sem alteracoes");
    return;
  }

  if (WiFi.SSID().length() > 0) {
    salvarConfigRede("ssid", WiFi.SSID());
    salvarConfigRede("senha", WiFi.psk());
  }
  String url = String(campoUrl.getValue());
  url.trim();
  if (url.startsWith("http")) salvarConfigRede("url", url);

  String token = String(campoToken.getValue());
  token.trim();
  if (token.startsWith(TOKEN_HW_PREFIXO)) {
    salvarConfigRede("token", token);
    salvarConfigRede("vinculo", "");
  } else if (token.length() > 0) {
    token.toUpperCase();
    salvarConfigRede("vinculo", token);
  }
  carregarConfigRede();
  mensagemInicializacao("Configuracao", "salva");
  delay(1200);
}

// Troca o token de vinculação pelo token definitivo (uma vez, no primeiro contato).
// Roda na tarefa de rede: cfgUrl/cfgToken/cfgVinculo só são tocados por ela depois do setup().
void atualizarVinculoHostinger() {
  if (cfgVinculo.length() == 0 || WiFi.status() != WL_CONNECTED) return;
  if (ultimaTentativaVinculoEm != 0 && millis() - ultimaTentativaVinculoEm < RETENTATIVA_VINCULO_MS) return;
  ultimaTentativaVinculoEm = millis();

  String payload = "{";
  payload += "\"codigo\":\"" + escaparJson(cfgVinculo) + "\",";
  payload += "\"firmware\":\"" FIRMWARE_VERSAO "\",";
  payload += "\"modelo\":\"" + escaparJson(String(ESP.getChipModel())) + "\",";
  payload += "\"mac\":\"" + escaparJson(WiFi.macAddress()) + "\"";
  payload += "}";

  String resposta;
  int status = requisicaoHttps("/vincular.php", &payload, false, &resposta);

  if (status == 200) {
    JsonDocument doc;
    if (!deserializeJson(doc, resposta) && doc["token"].is<const char*>()) {
      String token = doc["token"].as<String>();
      if (token.startsWith(TOKEN_HW_PREFIXO)) {
        salvarConfigRede("token", token);
        salvarConfigRede("vinculo", "");
        cfgToken = token;
        cfgVinculo = "";
        Serial.println("Dispositivo vinculado ao painel");
        avisarOLEDPelaRede("Vinculado!");
      }
    }
  } else if (status == 403) {
    // Token de vinculação inválido ou expirado: descarta (gere outro no painel).
    salvarConfigRede("vinculo", "");
    cfgVinculo = "";
    Serial.println("Token de vinculacao invalido ou expirado");
    avisarOLEDPelaRede("Vinculo invalido");
  } else {
    Serial.printf("Vinculo: HTTP %d, tentando de novo em 30 s\n", status);
  }
}

// ---------------- WIFI / HORA ----------------
// Conexão inicial (bloqueante, só no setup).
bool conectarWiFi() {
  WiFi.mode(WIFI_STA);
  WiFi.setAutoReconnect(true);
  WiFi.persistent(false);
  WiFi.disconnect(true, true);
  delay(100);
  WiFi.begin(cfgSsid.c_str(), cfgSenha.c_str());

  unsigned long inicio = millis();
  while (WiFi.status() != WL_CONNECTED && millis() - inicio < WIFI_TIMEOUT_MS) {
    delay(250);
  }

  Serial.print("Status WiFi: ");
  Serial.println(static_cast<int>(WiFi.status()));
  return WiFi.status() == WL_CONNECTED;
}

// Reconexão não bloqueante com backoff.
void atualizarConexaoWiFi() {
  wl_status_t statusAtual = WiFi.status();

  if (statusAtual == WL_CONNECTED) {
    if (!wifiConectado) {
      wifiConectado = true;
      wifiDesconectadoDesde = 0;
      Serial.println("WiFi reconectado");
    }
    return;
  }

  if (wifiConectado) {
    wifiConectado = false;
    wifiDesconectadoDesde = millis();
    Serial.println("WiFi desconectado");
  } else if (wifiDesconectadoDesde == 0) {
    wifiDesconectadoDesde = millis();
  }

  unsigned long tempoDesconectado = millis() - wifiDesconectadoDesde;
  unsigned long intervaloAtual = tempoDesconectado < JANELA_WIFI_INICIAL_MS
    ? RETENTATIVA_WIFI_INICIAL_MS
    : RETENTATIVA_WIFI_POSTERIOR_MS;

  if (millis() - ultimaTentativaWiFi < intervaloAtual) {
    return;
  }

  ultimaTentativaWiFi = millis();
  Serial.println("Tentando reconectar WiFi...");
  WiFi.mode(WIFI_STA);
  WiFi.disconnect(true, true);
  delay(100);
  WiFi.begin(cfgSsid.c_str(), cfgSenha.c_str());
}

const char* SERVIDORES_NTP[] = {
  "pool.ntp.org", "time.google.com", "a.st1.ntp.br", "time.windows.com"
};
const int TOTAL_SERVIDORES_NTP = sizeof(SERVIDORES_NTP) / sizeof(SERVIDORES_NTP[0]);
int indiceServidorNTP = 0;

// Pede a hora ao par de servidores da vez (não espera a resposta).
void iniciarNTP() {
  const char* servidorPrimario = SERVIDORES_NTP[indiceServidorNTP % TOTAL_SERVIDORES_NTP];
  const char* servidorSecundario = SERVIDORES_NTP[(indiceServidorNTP + 1) % TOTAL_SERVIDORES_NTP];

  Serial.print("NTP: tentando sincronizar com ");
  Serial.print(servidorPrimario);
  Serial.print(" / ");
  Serial.println(servidorSecundario);

  configTime(GMT_OFFSET_SEC, DAYLIGHT_OFFSET_SEC, servidorPrimario, servidorSecundario);
}

void falhaNTP() {
  Serial.println("NTP: falhou (timeout). Se isso se repetir com todos os servidores, "
                  "a rede provavelmente bloqueia a porta UDP 123 (comum em redes "
                  "corporativas/escolares) - teste com outra rede (ex: hotspot do celular).");
  indiceServidorNTP++; // roda para outro par de servidores na próxima tentativa
}

void concluirNTP(struct tm& timeinfo);

// Versão bloqueante (só no setup). Alterna pares de servidores a cada falha; ajusta o RTC.
bool sincronizarHoraNTP() {
  if (!wifiConectado) {
    return false;
  }

  iniciarNTP();

  struct tm timeinfo;
  unsigned long inicio = millis();
  while (!getLocalTime(&timeinfo, 0) && millis() - inicio < NTP_TIMEOUT_MS) {
    delay(250);
  }

  if (!getLocalTime(&timeinfo, 0)) {
    falhaNTP();
    return false;
  }

  concluirNTP(timeinfo);
  return true;
}

// Hora recebida: mostra no serial, ajusta o RTC e passa a usar o relógio do ESP32.
void concluirNTP(struct tm& timeinfo) {
  char bufferHora[32];
  snprintf(bufferHora, sizeof(bufferHora), "%04d-%02d-%02d %02d:%02d:%02d",
    timeinfo.tm_year + 1900, timeinfo.tm_mon + 1, timeinfo.tm_mday,
    timeinfo.tm_hour, timeinfo.tm_min, timeinfo.tm_sec);
  Serial.print("NTP: sincronizado com sucesso -> ");
  Serial.println(bufferHora);

  if (rtcDisponivel) {
    rtc.adjust(DateTime(
      timeinfo.tm_year + 1900,
      timeinfo.tm_mon + 1,
      timeinfo.tm_mday,
      timeinfo.tm_hour,
      timeinfo.tm_min,
      timeinfo.tm_sec
    ));
    Serial.println("NTP: RTC ajustado com a hora sincronizada");
  }

  horaSincronizada = true;
}

// Repete o NTP até a primeira sincronização, sem travar o loop(): pede a hora
// e confere a cada volta se ela chegou, até NTP_TIMEOUT_MS.
bool ntpEmAndamento = false;
unsigned long ntpIniciadoEm = 0;
void atualizarSincronizacaoHora() {
  if (horaSincronizada || !wifiConectado) {
    ntpEmAndamento = false;
    return;
  }

  if (!ntpEmAndamento) {
    if (millis() - ultimaTentativaNTP < RETENTATIVA_NTP_MS) return;
    ultimaTentativaNTP = millis();
    iniciarNTP();
    ntpEmAndamento = true;
    ntpIniciadoEm = millis();
    return;
  }

  struct tm timeinfo;
  if (getLocalTime(&timeinfo, 0)) {
    ntpEmAndamento = false;
    concluirNTP(timeinfo);
    atualizarOLED = true;
  } else if (millis() - ntpIniciadoEm >= NTP_TIMEOUT_MS) {
    ntpEmAndamento = false;
    falhaNTP();
  }
}

// Hora atual: relógio do ESP32 (após NTP) > RTC (ano >= 2024) > data fixa.
DateTime obterAgora() {
  if (horaSincronizada) {
    time_t agoraEpoch = time(nullptr);
    if (agoraEpoch > 100000) {
      // time() devolve UTC e DateTime(time_t) não aplica fuso: soma o offset aqui.
      return DateTime((uint32_t)(agoraEpoch + GMT_OFFSET_SEC + DAYLIGHT_OFFSET_SEC));
    }
  }

  if (rtcDisponivel) {
    DateTime agoraRTC = rtc.now();

    if (agoraRTC.year() >= 2024) {
      return agoraRTC;
    }
  }

  return DateTime(2026, 1, 1, 0, 0, 0);
}

// "AAAA-MM-DD HH:MM:SS" para os payloads da Hostinger.
String obterTimestampAtual() {
  DateTime now = obterAgora();
  char buffer[32];
  snprintf(
    buffer,
    sizeof(buffer),
    "%04d-%02d-%02d %02d:%02d:%02d",
    now.year(),
    now.month(),
    now.day(),
    now.hour(),
    now.minute(),
    now.second()
  );
  return String(buffer);
}

String valorJsonFloat(float valor, int casas) {
  return isnan(valor) ? String("null") : String(valor, casas);
}

String escaparJson(const String& valor) {
  String saida = "";
  saida.reserve(valor.length() + 8);

  for (int i = 0; i < valor.length(); i++) {
    char c = valor[i];
    if (c == '\\' || c == '"') {
      saida += '\\';
      saida += c;
    } else if (c == '\n') {
      saida += "\\n";
    } else if (c == '\r') {
      saida += "\\r";
    } else {
      saida += c;
    }
  }

  return saida;
}

// ===================== REDE: HTTPS reaproveitado (tarefa de rede) =====================
// Uma única conexão TLS com a Hostinger, mantida aberta entre as requisições (keep-alive).
// Antes cada requisição abria uma conexão nova (0,5 a 2 s de negociação no ESP32).
// O HTTPClient também é global: o destrutor dele fecharia a conexão.
WiFiClientSecure clienteHttps;
HTTPClient httpRede;
bool httpsPreparado = false;

// POST (corpo != nullptr) ou GET em cfgUrl + endpoint. Devolve o status HTTP (<= 0 = falha de rede).
// Se a conexão guardada tiver sido fechada pelo servidor, tenta de novo uma vez com uma conexão nova.
int requisicaoHttps(const char* endpoint, const String* corpo, bool comChave, String* resposta) {
  if (WiFi.status() != WL_CONNECTED) return -1;
  if (!httpsPreparado) {
    clienteHttps.setInsecure(); // HTTPS sem fixar certificado, mais simples para hospedagem compartilhada.
    clienteHttps.setHandshakeTimeout(15); // padrão de 120 s seguraria a tarefa de rede
    httpRede.setReuse(true);
    httpsPreparado = true;
  }

  String url = cfgUrl + endpoint;
  int status = -1;
  for (int tentativa = 0; tentativa < 2; tentativa++) {
    ultimaVoltaTarefaRedeEm = millis(); // uma requisição longa não é "tarefa travada"
    if (!httpRede.begin(clienteHttps, url)) {
      Serial.println("Hostinger: falha ao iniciar HTTP");
      return -1;
    }
    httpRede.setTimeout(HOSTINGER_HTTP_TIMEOUT_MS);
    if (comChave) httpRede.addHeader("X-API-Key", chaveServidor());
    if (corpo) {
      httpRede.addHeader("Content-Type", "application/json");
      status = httpRede.POST(*corpo);
    } else {
      status = httpRede.GET();
    }
    if (status > 0) {
      if (resposta) *resposta = httpRede.getString();
      httpRede.end();
      ultimaRespostaServidorEm = millis();
      falhasSeguidasServidor = 0;
      return status;
    }
    // Falha de rede (ex.: o servidor fechou a conexão parada): descarta e tenta de novo.
    httpRede.end();
    clienteHttps.stop();
  }
  falhasSeguidasServidor = falhasSeguidasServidor + 1;
  Serial.printf("Hostinger: sem resposta em %s (%s) | heap livre %u, maior bloco %u\n",
                endpoint, HTTPClient::errorToString(status).c_str(),
                (unsigned)ESP.getFreeHeap(), (unsigned)ESP.getMaxAllocHeap());
  return status;
}

bool enviarJsonHostinger(const char* endpoint, const String& payload) {
  int status = requisicaoHttps(endpoint, &payload, true, nullptr);
  bool ok = status >= 200 && status < 300;
  if (!ok) {
    Serial.print("Hostinger: erro HTTP ");
    Serial.print(status);
    Serial.print(" em ");
    Serial.println(endpoint);
  }
  return ok;
}

// ===================== loop() -> rede =====================
// Monta a leitura no loop() (lê os sensores e o RTC no próprio núcleo) e deixa na
// caixa de correio; a tarefa de rede envia quando puder.
void enviarLeituraHostinger() {
  String payload = "{";
  payload += "\"timestamp\":\"" + escaparJson(obterTimestampAtual()) + "\",";
  payload += "\"temp_interna\":" + valorJsonFloat(tempAtual, 1) + ",";
  payload += "\"umid_interna\":" + valorJsonFloat(umidAtual, 0) + ",";
  payload += "\"temp_externa\":" + valorJsonFloat(tempExterna, 1) + ",";
  payload += "\"umid_externa\":" + valorJsonFloat(umidExterna, 0) + ",";
  payload += "\"solo_percentual\":" + (soloValido ? String(soloPercentual) : String("null")) + ",";
  payload += "\"agua_distancia_cm\":" + valorJsonFloat(aguaDistanciaCm, 1) + ",";
  payload += "\"agua_litros\":" + valorJsonFloat(aguaLitros, 1) + ",";
  payload += "\"agua_percentual\":" + (isnan(aguaPercentual) ? String("null") : String((int)roundf(aguaPercentual))) + ",";
  // Status do dispositivo (opcionais: o servidor aceita leituras sem eles).
  payload += "\"firmware\":\"" FIRMWARE_VERSAO "\",";
  payload += "\"modelo\":\"" + escaparJson(String(ESP.getChipModel())) + "\",";
  payload += "\"mac\":\"" + escaparJson(WiFi.macAddress()) + "\",";
  payload += "\"rssi\":" + String(WiFi.RSSI()) + ",";
  payload += "\"uptime\":" + String((unsigned long)(millis() / 1000UL));
  payload += "}";

  TravaRede trava;
  leituraParaEnviar = payload;
  temLeituraParaEnviar = true;
}

void enfileirarComandoHostinger(const char* tipo, const char* alvo, const String& valor, const char* origem) {
  String payload = "{";
  payload += "\"timestamp\":\"" + escaparJson(obterTimestampAtual()) + "\",";
  payload += "\"tipo\":\"" + escaparJson(tipo) + "\",";
  payload += "\"alvo\":\"" + escaparJson(alvo) + "\",";
  payload += "\"valor\":\"" + escaparJson(valor) + "\",";
  payload += "\"origem\":\"" + escaparJson(origem) + "\"";
  payload += "}";

  TravaRede trava;
  if (filaComandosTotal >= HOSTINGER_FILA_COMANDOS_MAX) {
    filaComandosInicio = (filaComandosInicio + 1) % HOSTINGER_FILA_COMANDOS_MAX;
    filaComandosTotal--;
    Serial.println("Hostinger: fila de comandos cheia, descartando comando antigo");
  }

  filaComandosHostinger[filaComandosFim] = payload;
  filaComandosFim = (filaComandosFim + 1) % HOSTINGER_FILA_COMANDOS_MAX;
  filaComandosTotal++;
}

// Estado atual a cada 5 s para a Hostinger (estado_atual.php). É o que deixa o painel
// "ao vivo" sem nenhum serviço extra. Vai pela mesma conexão HTTPS, que fica aberta.
void atualizarEstadoHostinger() {
  if (millis() - ultimoEstadoHostingerEm < INTERVALO_ESTADO_HOSTINGER_MS) return;
  ultimoEstadoHostingerEm = millis();
  String json = montarJsonEstado();
  TravaRede trava;
  estadoParaHostinger = json;
  temEstadoParaHostinger = true;
}

// JSON do estado atual: mesmos nomes de campo das leituras do banco, mais fase, luz e relés.
// Montado no loop() (núcleo 1), que é dono dos sensores, dos relés e do RTC.
String montarJsonEstado() {
  float vpd = (isnan(tempAtual) || isnan(umidAtual)) ? NAN : calcularVPD(tempAtual, umidAtual);
  String json = "{";
  json += "\"dispositivo_timestamp\":\"" + escaparJson(obterTimestampAtual()) + "\",";
  json += "\"temp_interna\":" + valorJsonFloat(tempAtual, 1) + ",";
  json += "\"umid_interna\":" + valorJsonFloat(umidAtual, 0) + ",";
  json += "\"temp_externa\":" + valorJsonFloat(tempExterna, 1) + ",";
  json += "\"umid_externa\":" + valorJsonFloat(umidExterna, 0) + ",";
  json += "\"vpd\":" + valorJsonFloat(vpd, 2) + ",";
  json += "\"solo_percentual\":" + (soloValido ? String(soloPercentual) : String("null")) + ",";
  json += "\"agua_distancia_cm\":" + valorJsonFloat(aguaDistanciaCm, 1) + ",";
  json += "\"agua_litros\":" + valorJsonFloat(aguaLitros, 1) + ",";
  json += "\"agua_percentual\":" + (isnan(aguaPercentual) ? String("null") : String((int)roundf(aguaPercentual))) + ",";
  json += "\"modo_cultivo\":\"" + String(modoAtual == FLORACAO ? "floracao" : "vegetativo") + "\",";
  json += "\"luz_controle\":\"" + String(modoControleLuz == LUZ_AUTOMATICA ? "auto" : (modoControleLuz == LUZ_MANUAL_LIGADA ? "ligada" : "desligada")) + "\",";
  json += "\"reles\":{";
  for (int i = 0; i < TOTAL_RELES; i++) {
    if (i) json += ",";
    json += "\"" + escaparJson(nomeReleControle(i)) + "\":" + (estadoReles[i] ? "1" : "0");
  }
  json += "}";
  json += "}";
  return json;
}

// ===================== rede -> loop() =====================
// Comandos do painel chegam pela tarefa de rede e são aplicados aqui, no núcleo 1,
// junto com o resto da lógica dos relés (nada de mexer em relé pelo núcleo 0).
void processarComandosRemotos() {
  ComandoRemoto c;
  while (xQueueReceive(filaComandosRemotos, &c, 0) == pdTRUE) {
    aplicarComandoRemotoWeb(String(c.tipo), String(c.alvo), String(c.valor));
  }
}

void avisarOLEDPelaRede(const char* texto) {
  TravaRede trava;
  strlcpy(mensagemRedeOLED, texto, sizeof(mensagemRedeOLED));
  temMensagemRedeOLED = true;
}

void mostrarMensagemDaRede() {
  char texto[sizeof(mensagemRedeOLED)];
  {
    TravaRede trava;
    if (!temMensagemRedeOLED) return;
    strlcpy(texto, mensagemRedeOLED, sizeof(texto));
    temMensagemRedeOLED = false;
  }
  mostrarMensagemTemporaria(texto, 2500);
}

// ===================== tarefa de rede (núcleo 0) =====================
void atualizarFilaComandosHostinger() {
  if (millis() - ultimoEnvioComandoHostingerEm < INTERVALO_ENVIO_COMANDOS_HOSTINGER_MS) return;

  String payload;
  {
    TravaRede trava;
    if (filaComandosTotal <= 0) return;
    payload = filaComandosHostinger[filaComandosInicio];
  }

  ultimoEnvioComandoHostingerEm = millis();
  if (!enviarJsonHostinger("/registrar_comando.php", payload)) {
    return;
  }

  // Tira da fila só depois de enviado. Se a fila transbordou enquanto enviava,
  // o item já foi descartado pelo enfileirar e não há o que tirar.
  TravaRede trava;
  if (filaComandosTotal > 0 && filaComandosHostinger[filaComandosInicio] == payload) {
    filaComandosHostinger[filaComandosInicio] = "";
    filaComandosInicio = (filaComandosInicio + 1) % HOSTINGER_FILA_COMANDOS_MAX;
    filaComandosTotal--;
  }
}

void atualizarEnvioEstadoRede() {
  String payload;
  {
    TravaRede trava;
    if (!temEstadoParaHostinger) return;
    payload = estadoParaHostinger;
    temEstadoParaHostinger = false;
  }
  // Estado perdido não é reenviado: o próximo vem em 5 s.
  enviarJsonHostinger("/estado_atual.php", payload);
}

void atualizarEnvioLeituraRede() {
  String payload;
  {
    TravaRede trava;
    if (!temLeituraParaEnviar) return;
    payload = leituraParaEnviar;
    temLeituraParaEnviar = false;
  }
  // Uma leitura perdida não é reenviada: a próxima chega em 1 min (como antes).
  enviarJsonHostinger("/registrar_leitura.php", payload);
}

void atualizarComandosPendentesHostinger();

void tarefaRede(void* parametro) {
  (void)parametro;
  for (;;) {
    ultimaVoltaTarefaRedeEm = millis();
    if (WiFi.status() == WL_CONNECTED) {
      atualizarVinculoHostinger();
      atualizarFilaComandosHostinger(); // eventos primeiro: o painel confirma os comandos por eles
      atualizarEnvioEstadoRede();
      atualizarEnvioLeituraRede();
      atualizarComandosPendentesHostinger();
    }
    vTaskDelay(pdMS_TO_TICKS(20));
  }
}

void iniciarTarefaRede() {
  filaComandosRemotos = xQueueCreate(FILA_COMANDOS_REMOTOS_MAX, sizeof(ComandoRemoto));
  ultimaVoltaTarefaRedeEm = millis();
  vigiaReferenciaEm = millis();
  xTaskCreatePinnedToCore(tarefaRede, "rede", TAREFA_REDE_PILHA, nullptr,
                          TAREFA_REDE_PRIORIDADE, nullptr, TAREFA_REDE_NUCLEO);
  tarefaRedeIniciada = true;
}

// ===================== vigia da conexão (loop) =====================
void reiniciarPeloVigia(uint32_t motivo, unsigned long semRespostaSeg) {
  vigiaMarcador = VIGIA_MARCADOR;
  vigiaReiniciosSeguidos = vigiaReiniciosSeguidos + 1;
  vigiaMotivo = motivo;
  vigiaSemRespostaSeg = semRespostaSeg;
  Serial.printf("VIGIA: %s ha %lu s - reiniciando o ESP32 (reinicio seguido n. %u)\n",
                motivo == 2 ? "tarefa de rede parada" : "sem resposta do servidor",
                semRespostaSeg, (unsigned)vigiaReiniciosSeguidos);
  Serial.flush();
  delay(200);
  ESP.restart();
}

// No boot: lê o motivo deixado pelo vigia e avisa o painel (o evento sai quando a rede voltar).
void iniciarVigiaRede() {
  if (vigiaMarcador != VIGIA_MARCADOR) { // primeiro boot ou falta de energia: memória com lixo
    vigiaMarcador = VIGIA_MARCADOR;
    vigiaReiniciosSeguidos = 0;
    vigiaMotivo = 0;
    vigiaSemRespostaSeg = 0;
    return;
  }
  // Reinício pelo watchdog do loop (o controle travou): avisa o painel.
  esp_reset_reason_t motivoReset = esp_reset_reason();
  if (motivoReset == ESP_RST_TASK_WDT || motivoReset == ESP_RST_INT_WDT || motivoReset == ESP_RST_WDT) {
    Serial.printf("VIGIA: este boot veio do watchdog (motivo %d) - o loop travou\n", (int)motivoReset);
    enfileirarComandoHostinger("dispositivo", "conexao", "recuperacao:loop:0", "vigia");
  }
  if (vigiaMotivo != 0) {
    Serial.printf("VIGIA: este boot foi um reinicio automatico (motivo %u, %u s sem resposta)\n",
                  (unsigned)vigiaMotivo, (unsigned)vigiaSemRespostaSeg);
    String valor = String(vigiaMotivo == 2 ? "recuperacao:travada:" : "recuperacao:reinicio:") + String(vigiaSemRespostaSeg);
    enfileirarComandoHostinger("dispositivo", "conexao", valor, "vigia");
    vigiaMotivo = 0;
  }
}

void atualizarVigiaRede() {
  unsigned long agora = millis();

  // O servidor respondeu: zera a sequência de reinícios.
  if (ultimaRespostaServidorEm != 0 && vigiaReiniciosSeguidos != 0) vigiaReiniciosSeguidos = 0;

  if (agora - ultimoStatusRedeSerialEm >= STATUS_REDE_SERIAL_MS) {
    ultimoStatusRedeSerialEm = agora;
    unsigned long ref = ultimaRespostaServidorEm;
    Serial.printf("Rede: WiFi %s (%d dBm) | ultima resposta do servidor %s%lu s | falhas seguidas %u | heap livre %u, maior bloco %u\n",
                  wifiConectado ? "ok" : "desconectado", wifiConectado ? WiFi.RSSI() : 0,
                  ref ? "ha " : "nunca, ", ref ? (agora - ref) / 1000 : agora / 1000,
                  (unsigned)falhasSeguidasServidor, (unsigned)ESP.getFreeHeap(), (unsigned)ESP.getMaxAllocHeap());
  }

  if (agora - ultimaVerificacaoVigiaEm < VIGIA_INTERVALO_MS) return;
  ultimaVerificacaoVigiaEm = agora;
  if (!tarefaRedeIniciada) return;

  // Tarefa de rede presa numa chamada (nenhuma passa de ~45 s com os timeouts).
  unsigned long voltaRede = ultimaVoltaTarefaRedeEm;
  if (agora - voltaRede > VIGIA_TAREFA_TRAVADA_MS) reiniciarPeloVigia(2, (agora - voltaRede) / 1000);

  // Wi-Fi caído é com o atualizarConexaoWiFi(); sem servidor configurado não há o que vigiar.
  // A queda provocada pelo próprio vigia não zera a contagem (senão nunca chegaria aos 10 min);
  // só uma queda real (mais de 1 min depois da reconexão forçada) recomeça a contagem.
  if (!wifiConectado || cfgUrl.length() == 0) {
    bool quedaDoVigia = ultimaReconexaoForcadaEm != 0 && agora - ultimaReconexaoForcadaEm < 60000UL;
    if (!quedaDoVigia) vigiaReferenciaEm = agora;
    return;
  }

  unsigned long resposta = ultimaRespostaServidorEm;
  unsigned long base = (resposta != 0 && (long)(resposta - vigiaReferenciaEm) > 0) ? resposta : vigiaReferenciaEm;
  unsigned long semResposta = agora - base;
  unsigned long limiteReinicio = vigiaReiniciosSeguidos >= VIGIA_REINICIOS_ANTES_DE_ESPACAR
    ? VIGIA_REINICIAR_ESPACADO_MS : VIGIA_REINICIAR_MS;

  if (semResposta >= limiteReinicio) {
    reiniciarPeloVigia(1, semResposta / 1000);
  } else if (semResposta >= VIGIA_RECONECTAR_WIFI_MS &&
             (ultimaReconexaoForcadaEm == 0 || agora - ultimaReconexaoForcadaEm >= VIGIA_RECONECTAR_WIFI_MS)) {
    ultimaReconexaoForcadaEm = agora;
    Serial.printf("VIGIA: WiFi conectado mas sem resposta do servidor ha %lu s - reconectando o WiFi\n", semResposta / 1000);
    enfileirarComandoHostinger("dispositivo", "conexao", "recuperacao:wifi:" + String(semResposta / 1000), "vigia");
    WiFi.disconnect(); // atualizarConexaoWiFi() percebe e reconecta em seguida
  }
}

// Aplica um comando da fila do dashboard (mesmo tipo/alvo/valor de enviar_comando.php).
void aplicarComandoRemotoWeb(const String& tipo, const String& alvo, const String& valor) {
  if (tipo == "rele") {
    int indiceRele = -1;
    for (int i = 0; i < TOTAL_RELES_MANUAIS; i++) {
      if (String(nomeReleControle(RELES_MANUAIS[i])) == alvo) {
        indiceRele = RELES_MANUAIS[i];
        break;
      }
    }
    if (indiceRele < 0) {
      Serial.println("Hostinger: comando remoto com rele desconhecido: " + alvo);
      return;
    }
    aplicarComandoRele(indiceRele, valor == "ligado" ? 1 : 0);
  } else if (tipo == "modo_cultivo") {
    definirModoCultivoRemoto(valor == "floracao" ? FLORACAO : VEGETACAO);
  } else if (tipo == "luz_manual") {
    ModoControleLuz novoModo = LUZ_AUTOMATICA;
    if (valor == "ligada") novoModo = LUZ_MANUAL_LIGADA;
    else if (valor == "desligada") novoModo = LUZ_MANUAL_DESLIGADA;
    definirModoControleLuzRemoto(novoModo);
  } else if (tipo == "acesso") {
    liberarAcessoRemoto();
  } else if (tipo == "luz_duracao") {
    definirDuracaoLuzRemoto(valor.toInt());
  } else if (tipo == "clima_vpd") {
    definirClimaRemoto(valor);
  } else if (tipo == "fotoperiodo") {
    // valor = "HH:MM" (início da luz); a duração vem do modo.
    int h = -1, m = -1;
    if (valor.length() != 5 || valor.charAt(2) != ':' || sscanf(valor.c_str(), "%d:%d", &h, &m) != 2 ||
        h < 0 || h > 23 || m < 0 || m > 59) {
      Serial.println("Hostinger: horario de fotoperiodo invalido: " + valor);
      return;
    }
    if (alvo == "vegetativo") definirFotoperiodoRemoto(VEGETACAO, h * 60 + m);
    else if (alvo == "floracao") definirFotoperiodoRemoto(FLORACAO, h * 60 + m);
    else Serial.println("Hostinger: modo de fotoperiodo desconhecido: " + alvo);
  } else {
    Serial.println("Hostinger: tipo de comando remoto desconhecido: " + tipo);
  }
}

// Polling da fila do dashboard. O servidor marca como entregue na mesma
// resposta (pode perder um comando se a rede cair no meio).
void atualizarComandosPendentesHostinger() {
  if (millis() - ultimaConsultaComandosPendentesEm < INTERVALO_POLL_COMANDOS_HOSTINGER_MS) return;
  ultimaConsultaComandosPendentesEm = millis();

  String resposta;
  int status = requisicaoHttps("/comandos_pendentes.php", nullptr, true, &resposta);
  if (status != 200) {
    if (status > 0) {
      Serial.print("Hostinger: erro HTTP ");
      Serial.print(status);
      Serial.println(" em /comandos_pendentes.php");
    }
    return;
  }

  JsonDocument doc;
  DeserializationError erroJson = deserializeJson(doc, resposta);
  if (erroJson) {
    Serial.print("Hostinger: JSON invalido em comandos pendentes: ");
    Serial.println(erroJson.c_str());
    return;
  }

  if (!(doc["ok"] | false)) return;

  // Entrega cada comando ao loop() (núcleo 1), que é quem mexe nos relés.
  JsonArray comandos = doc["comandos"].as<JsonArray>();
  for (JsonObject c : comandos) {
    const char* tipo = c["tipo"] | "";
    const char* alvo = c["alvo"] | "";
    const char* valor = c["valor"] | "";
    if (!*tipo || !*alvo || !*valor) continue;
    ComandoRemoto cmd;
    strlcpy(cmd.tipo, tipo, sizeof(cmd.tipo));
    strlcpy(cmd.alvo, alvo, sizeof(cmd.alvo));
    strlcpy(cmd.valor, valor, sizeof(cmd.valor));
    // Espera até 1 s se a fila estiver cheia (o loop() esvazia a cada volta).
    if (xQueueSend(filaComandosRemotos, &cmd, pdMS_TO_TICKS(1000)) != pdTRUE) {
      Serial.println("Hostinger: fila de comandos remotos cheia, comando descartado");
    }
  }
}

// Eventos executados (local ou remoto) enviados à Hostinger.
void registrarEventoModo(const char* estadoModo, const char* origem) {
  enfileirarComandoHostinger("modo_cultivo", "modo_cultivo", estadoModo, origem);
}

void registrarEventoRele(int indiceRele, bool ligado, const char* origem) {
  enfileirarComandoHostinger("rele", nomeReleControle(indiceRele), ligado ? "ligado" : "desligado", origem);
}

void registrarEventoAcesso(const char* origem, const char* resultado) {
  enfileirarComandoHostinger("acesso", "Trava Acesso", resultado, origem);
}

// Confirma o horário de luz em uso; o dashboard compara com o pedido.
void registrarEventoFotoperiodo(ModoCultivo modo, const char* origem) {
  int inicio = (modo == VEGETACAO) ? inicioLuzVegetacaoMin : inicioLuzFloracaoMin;
  char hhmm[12];
  snprintf(hhmm, sizeof(hhmm), "%02d:%02d", (inicio / 60) % 24, inicio % 60);
  enfileirarComandoHostinger("fotoperiodo", modo == VEGETACAO ? "vegetativo" : "floracao", String(hhmm), origem);
}

void definirFotoperiodoRemoto(ModoCultivo modo, int inicioMin) {
  if (!inicioLuzValido(inicioMin)) return;
  int& alvo = (modo == VEGETACAO) ? inicioLuzVegetacaoMin : inicioLuzFloracaoMin;
  if (alvo != inicioMin) {
    alvo = inicioMin;
    salvarFotoperiodoNaMemoria();
    mostrarMensagemTemporaria(modo == VEGETACAO ? "Timer Veg salvo" : "Timer Flora salvo", 1500);
    atualizarOLED = true;
  }
  // Confirma mesmo se não mudou — o painel fica sabendo que o comando chegou.
  registrarEventoFotoperiodo(modo, "web");
}

// ---------------- SENSOR DE AR ----------------
// Só atualiza se variar >= 0.1°C ou 1%; pisca o indicador a cada leitura válida.
void atualizarDHT() {
  if (millis() - ultimoDHT < INTERVALO_DHT_MS) return;
  ultimoDHT = millis();

  float novaTemp = NAN;
  float novaUmid = NAN;

#if WOKWI_SIMULATION
  for (int tentativa = 0; tentativa < 3; tentativa++) {
    novaTemp = dht.readTemperature();
    novaUmid = dht.readHumidity();

    if (!isnan(novaTemp) && !isnan(novaUmid)) {
      break;
    }

    delay(20);
  }
#else
  if (sht40Disponivel) {
    sensors_event_t humidity, temp;
    memset(&humidity, 0, sizeof(humidity));
    memset(&temp, 0, sizeof(temp));

    if (sht4.getEvent(&humidity, &temp)) {
      novaTemp = temp.temperature;
      novaUmid = humidity.relative_humidity;
    } else {
      // Falha de CRC/timeout: mantém NAN.
      Serial.println("Falha na leitura do SHT40 (CRC/timeout)");
    }
  }
#endif

  if (!isnan(novaTemp) && (isnan(tempAtual) || fabs(tempAtual - novaTemp) >= 0.1f)) {
    tempAtual = novaTemp;
    atualizarOLED = true;
  }

  if (!isnan(novaUmid) && (isnan(umidAtual) || fabs(umidAtual - novaUmid) >= 1.0f)) {
    umidAtual = novaUmid;
    atualizarOLED = true;
  }

  // Indicador de sensor vivo, mesmo sem mudança de valor.
  if (!isnan(novaTemp) && !isnan(novaUmid)) {
    pulsoSensorAtivo = true;
    pulsoSensorAte = millis() + DURACAO_PULSO_SENSOR_MS;
    if (telaSelecionada == TELA_PRINCIPAL && estadoOLED == OLED_EXIBINDO) {
      atualizarOLED = true;
    }
  }
}

void atualizarPulsoSensor() {
  if (pulsoSensorAtivo && prazoVencido(pulsoSensorAte)) {
    pulsoSensorAtivo = false;
    if (telaSelecionada == TELA_PRINCIPAL && estadoOLED == OLED_EXIBINDO) {
      atualizarOLED = true;
    }
  }
}

// Sensor externo: mesma lógica do interno, com indicador próprio.
void atualizarDHTExterno() {
  if (millis() - ultimoDHTExterno < INTERVALO_DHT_EXTERNO_MS) return;
  ultimoDHTExterno = millis();

  float novaTemp = dhtExterno.readTemperature();
  float novaUmid = dhtExterno.readHumidity();
  bool mudou = false;

  if (!isnan(novaTemp) && (isnan(tempExterna) || fabs(tempExterna - novaTemp) >= 0.1f)) {
    tempExterna = novaTemp;
    mudou = true;
  }

  if (!isnan(novaUmid) && (isnan(umidExterna) || fabs(umidExterna - novaUmid) >= 1.0f)) {
    umidExterna = novaUmid;
    mudou = true;
  }

  if (mudou && telaSelecionada == TELA_PRINCIPAL && estadoOLED == OLED_EXIBINDO) {
    atualizarOLED = true;
  }

  if (!isnan(novaTemp) && !isnan(novaUmid)) {
    pulsoSensorExternoAtivo = true;
    pulsoSensorExternoAte = millis() + DURACAO_PULSO_SENSOR_MS;
    if (telaSelecionada == TELA_PRINCIPAL && estadoOLED == OLED_EXIBINDO) {
      atualizarOLED = true;
    }
  }
}

void atualizarPulsoSensorExterno() {
  if (pulsoSensorExternoAtivo && prazoVencido(pulsoSensorExternoAte)) {
    pulsoSensorExternoAtivo = false;
    if (telaSelecionada == TELA_PRINCIPAL && estadoOLED == OLED_EXIBINDO) {
      atualizarOLED = true;
    }
  }
}

// ---------------- SOLO (capacitivo v1.2) ----------------
void atualizarSolo() {
  if (millis() - ultimoSolo < INTERVALO_SOLO_MS) return;
  ultimoSolo = millis();

  // 16 leituras em mV; descarta as 4 maiores e as 4 menores (ruído do ADC e do oscilador do sensor).
  int amostras[SOLO_AMOSTRAS];
  for (int i = 0; i < SOLO_AMOSTRAS; i++) {
    amostras[i] = analogReadMilliVolts(SOIL_PIN);
    delayMicroseconds(200);
  }
  for (int i = 1; i < SOLO_AMOSTRAS; i++) {  // ordenação por inserção
    int v = amostras[i], j = i - 1;
    while (j >= 0 && amostras[j] > v) { amostras[j + 1] = amostras[j]; j--; }
    amostras[j + 1] = v;
  }
  long soma = 0;
  for (int i = 4; i < SOLO_AMOSTRAS - 4; i++) soma += amostras[i];
  int mv = soma / (SOLO_AMOSTRAS - 8);
  soloMv = mv;

  // Fora da faixa elétrica do sensor: solto, sem alimentação ou fio de sinal flutuando.
  bool foraDaFaixa = mv < SOLO_MV_MINIMO_VALIDO || mv > SOLO_MV_MAXIMO_VALIDO;
  if (foraDaFaixa) {
    if (++soloFalhas >= SOLO_FALHAS_PARA_INVALIDAR && soloValido) {
      soloValido = false;
      atualizarOLED = true;
      Serial.printf("Solo - sem leitura (%d mV fora de %d-%d)\n", mv, SOLO_MV_MINIMO_VALIDO, SOLO_MV_MAXIMO_VALIDO);
    }
    return;
  }
  soloFalhas = 0;

  // Invertido: mais mV = mais seco (0%), menos mV = mais úmido (100%).
  float fracao = (float)(SOLO_MV_SECO - mv) / (float)(SOLO_MV_SECO - SOLO_MV_UMIDO);
  int percentual = constrain((int)roundf(fracao * 100.0f), 0, 100);

  if (percentual != soloPercentual || !soloValido) {
    soloPercentual = percentual;
    soloValido = true;
    atualizarOLED = true;
    Serial.printf("Solo - mV: %d | Umidade: %d%%\n", soloMv, soloPercentual);
  }

  pulsoSensorSoloAtivo = true;
  pulsoSensorSoloAte = millis() + DURACAO_PULSO_SENSOR_MS;
  if (telaSelecionada == TELA_PRINCIPAL && estadoOLED == OLED_EXIBINDO) {
    atualizarOLED = true;
  }
}

// ---------------- CAIXA D'ÁGUA (HC-SR04) ----------------
// Uma medição: pulso de 10 µs no TRIG e tempo do eco no ECHO. Compensa a velocidade do som
// pela temperatura (331,3 + 0,606·T m/s). NAN se não houver eco.
float medirDistanciaAguaCm() {
  digitalWrite(AGUA_TRIG_PIN, LOW);
  delayMicroseconds(3);
  digitalWrite(AGUA_TRIG_PIN, HIGH);
  delayMicroseconds(10);
  digitalWrite(AGUA_TRIG_PIN, LOW);
  unsigned long duracao = pulseIn(AGUA_ECHO_PIN, HIGH, AGUA_TIMEOUT_US);
  if (duracao == 0) return NAN;
  float temp = isnan(tempExterna) ? (isnan(tempAtual) ? 20.0f : tempAtual) : tempExterna;
  float somMs = 331.3f + 0.606f * temp;
  return duracao * somMs / 20000.0f;  // µs * m/s -> cm, dividido por 2 (ida e volta)
}

// Não bloqueante: 5 medições espaçadas de 70 ms a cada 10 s, depois a mediana vira nível, litros e %.
void atualizarNivelAgua() {
  if (pingsAguaFeitos == 0 && ultimoCicloAguaEm != 0 && millis() - ultimoCicloAguaEm < INTERVALO_AGUA_MS) return;
  if (pingsAguaFeitos > 0 && millis() - ultimoPingAguaEm < AGUA_ENTRE_PINGS_MS) return;
  if (pingsAguaFeitos == 0) ultimoCicloAguaEm = millis();
  ultimoPingAguaEm = millis();
  pingsAgua[pingsAguaFeitos++] = medirDistanciaAguaCm();
  if (pingsAguaFeitos < AGUA_PINGS) return;
  pingsAguaFeitos = 0;

  // Só medições plausíveis: fora da zona cega e no máximo 20 cm além do fundo.
  float validas[AGUA_PINGS];
  int n = 0;
  for (int i = 0; i < AGUA_PINGS; i++) {
    float d = pingsAgua[i];
    if (!isnan(d) && d >= AGUA_DISTANCIA_MINIMA_CM && d <= AGUA_SENSOR_ATE_FUNDO_CM + 20.0f) validas[n++] = d;
  }
  if (n < 3) {
    if (++aguaFalhas >= AGUA_FALHAS_PARA_INVALIDAR && !isnan(aguaPercentual)) {
      aguaDistanciaCm = aguaNivelCm = aguaLitros = aguaPercentual = NAN;
      atualizarOLED = true;
      Serial.println("Caixa d'agua - sem leitura do HC-SR04 (verifique o divisor no ECHO e a alimentacao em 5 V)");
    }
    return;
  }
  aguaFalhas = 0;
  for (int i = 1; i < n; i++) {  // mediana
    float v = validas[i];
    int j = i - 1;
    while (j >= 0 && validas[j] > v) { validas[j + 1] = validas[j]; j--; }
    validas[j + 1] = v;
  }
  float distancia = validas[n / 2];
  float nivel = constrain(AGUA_SENSOR_ATE_FUNDO_CM - distancia, 0.0f, CAIXA_ALTURA_CM);
  float litros = CAIXA_COMPRIMENTO_CM * CAIXA_LARGURA_CM * nivel / 1000.0f;
  float percentual = constrain(litros / CAIXA_CAPACIDADE_L * 100.0f, 0.0f, 100.0f);

  bool mudou = isnan(aguaLitros) || fabs(aguaLitros - litros) >= 0.5f;
  aguaDistanciaCm = distancia;
  aguaNivelCm = nivel;
  aguaLitros = litros;
  aguaPercentual = percentual;
  if (mudou) {
    atualizarOLED = true;
    Serial.printf("Caixa d'agua - distancia %.1f cm | nivel %.1f cm | %.1f L (%.0f%%)\n", distancia, nivel, litros, percentual);
  }

  // Proteção da bomba: caixa abaixo de 10% desliga a irrigação na hora.
  if (irrigacaoBloqueadaPelaAgua() && estadoReles[RELE_IRRIGACAO]) {
    acionarRele(RELE_IRRIGACAO, false);
    registrarEventoRele(RELE_IRRIGACAO, false, "protecao_agua");
    salvarEstadoNaMemoria();
    Serial.println("Irrigacao desligada: caixa d'agua abaixo de 10% (protecao da bomba)");
  }
}

void atualizarPulsoSensorSolo() {
  if (pulsoSensorSoloAtivo && prazoVencido(pulsoSensorSoloAte)) {
    pulsoSensorSoloAtivo = false;
    if (telaSelecionada == TELA_PRINCIPAL && estadoOLED == OLED_EXIBINDO) {
      atualizarOLED = true;
    }
  }
}

// ---------------- FOTOPERÍODO ----------------
void janelaLuzAtual(int& inicio, int& fim) {
  if (modoAtual == VEGETACAO) {
    inicio = inicioLuzVegetacaoMin;
    fim = (inicioLuzVegetacaoMin + DURACAO_LUZ_VEGETACAO_MIN) % (24 * 60);
  } else {
    inicio = inicioLuzFloracaoMin;
    fim = (inicioLuzFloracaoMin + DURACAO_LUZ_FLORACAO_MIN) % (24 * 60);
  }
}

bool luzDeveEstarLigada(const DateTime& now) {
  int minutosAgora = now.hour() * 60 + now.minute();
  int inicio, fim;
  janelaLuzAtual(inicio, fim);

  if (inicio < fim) {
    return minutosAgora >= inicio && minutosAgora < fim;
  }
  return minutosAgora >= inicio || minutosAgora < fim;
}

const unsigned long ESPERA_HORA_LUZ_MS = 10UL * 60UL * 1000UL;

// Override manual sobrepõe o resultado, mas o timer continua sendo calculado.
void controlarLuz(const DateTime& now) {
  if (modoControleLuz != LUZ_AUTOMATICA && overrideLuzAte != 0 && prazoVencido(overrideLuzAte)) {
    modoControleLuz = LUZ_AUTOMATICA;
    overrideLuzAte = 0;
    atualizarOLED = true;
  }

  bool estadoAnterior = estadoReles[RELE_LUZ];

  // RTC parou (sem bateria) e o NTP ainda não respondeu: a hora é a da compilação, não a real.
  // Mantém a luz como estava antes de desligar por até 10 min, esperando a hora certa.
  bool estadoAutomatico = (!horaConfiavel() && millis() < ESPERA_HORA_LUZ_MS)
    ? estadoAnterior : luzDeveEstarLigada(now);
  bool novoEstado;

  switch (modoControleLuz) {
    case LUZ_MANUAL_LIGADA:
      novoEstado = true;
      break;
    case LUZ_MANUAL_DESLIGADA:
      novoEstado = false;
      break;
    case LUZ_AUTOMATICA:
    default:
      novoEstado = estadoAutomatico;
      break;
  }

  acionarRele(RELE_LUZ, novoEstado);
  if (estadoAnterior != novoEstado) salvarLuz(novoEstado);

  // Na primeira passada depois de ligar, informa o estado da luz mesmo sem mudança.
  static bool luzInformadaAposBoot = false;
  if (estadoAnterior != novoEstado || !luzInformadaAposBoot) {
    registrarEventoRele(RELE_LUZ, novoEstado, modoControleLuz == LUZ_AUTOMATICA ? "automatico_luz" : "override_manual_luz");
    luzInformadaAposBoot = true;
    atualizarOLED = true;
  }
}

// Tempo até a luz trocar de estado ("HHhMMm"), tratando a virada da meia-noite.
String tempoRestante(const DateTime& now) {
  int minutosAgora = now.hour() * 60 + now.minute();

  int inicio;
  int fim;
  janelaLuzAtual(inicio, fim);

  bool ligado;
  int minutosRestantes;

  if (inicio < fim) {
    ligado = (minutosAgora >= inicio && minutosAgora < fim);

    if (ligado) {
      minutosRestantes = fim - minutosAgora;
    } else {
      if (minutosAgora < inicio) {
        minutosRestantes = inicio - minutosAgora;
      } else {
        minutosRestantes = (24 * 60 - minutosAgora) + inicio;
      }
    }
  } else {
    ligado = (minutosAgora >= inicio || minutosAgora < fim);

    if (ligado) {
      if (minutosAgora >= inicio) {
        minutosRestantes = (24 * 60 - minutosAgora) + fim;
      } else {
        minutosRestantes = fim - minutosAgora;
      }
    } else {
      minutosRestantes = inicio - minutosAgora;
    }
  }

  int horas = minutosRestantes / 60;
  int minutos = minutosRestantes % 60;

  char buffer[10];
  snprintf(buffer, sizeof(buffer), "%02dh%02dm", horas, minutos);
  return String(buffer);
}

// Tempo até o override manual expirar ("HHhMMm").
String tempoRestanteOverrideLuz() {
  unsigned long restanteMs = msAtePrazo(overrideLuzAte);
  unsigned long minutosRestantes = restanteMs / 60000UL;

  int horas = minutosRestantes / 60;
  int minutos = minutosRestantes % 60;

  char buffer[10];
  snprintf(buffer, sizeof(buffer), "%02dh%02dm", horas, minutos);
  return String(buffer);
}

// Botão físico que libera a trava.
void atualizarBotaoAcesso() {
  static bool ultimoEstadoLido = HIGH;
  static bool estadoEstavel = HIGH;
  static unsigned long debounce = 0;
  static bool acionamentoProcessado = false;

  bool leitura = digitalRead(BOTAO_TRV_PIN);

  if (leitura != ultimoEstadoLido) {
    debounce = millis();
    ultimoEstadoLido = leitura;
  }

  if ((millis() - debounce) < DEBOUNCE_BOTAO_MS) {
    return;
  }

  if (leitura != estadoEstavel) {
    estadoEstavel = leitura;

    if (estadoEstavel == HIGH) {
      acionamentoProcessado = false;
    }
  }

  if (estadoEstavel == LOW && !acionamentoProcessado) {
      acionamentoProcessado = true;

      liberarAcessoPor(3000);
      beep(150);
      mostrarMensagemTemporaria("Porta Liberada", 1500);
      registrarEventoAcesso("botao", "liberado");
  }
}
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
void loop() {
  esp_task_wdt_reset();         // "estou vivo" para o watchdog do loop
  atualizarLEDVPD();            // cor do NeoPixel reflete a zona do VPD atual
  atualizarBuzzer();           // desliga o beep quando o tempo expira
  atualizarAcesso();           // fecha a trava quando o tempo expira
  atualizarMensagemTemporaria(); // fecha mensagens temporárias do OLED
  atualizarBotaoOLED();        // lê o botão de navegação (debounce + clique curto/longo)
  atualizarBotaoAcesso();      // lê o botão físico de liberar acesso
  atualizarTimeoutOLED();      // volta pra tela de descanso por inatividade
  atualizarDHT();              // lê temperatura/umidade do ar (a cada 2s)
  atualizarDHTExterno();       // lê temperatura/umidade externas (fora da estufa)
  atualizarPulsoSensor();      // apaga o indicador de "sensor vivo" (interno)
  atualizarPulsoSensorExterno(); // apaga o indicador de "sensor vivo" (externo)
  atualizarSolo();             // lê umidade do solo (a cada 1s, com média)
  atualizarNivelAgua();        // caixa d'água pelo HC-SR04 (a cada 10s, mediana de 5)
  atualizarPulsoSensorSolo();  // apaga o indicador de "sensor vivo" (solo)
  atualizarSincronizacaoHora(); // tenta NTP periodicamente até sincronizar
  atualizarConexaoWiFi();      // reconecta WiFi com backoff se cair
  // A rede roda na tarefaRede (núcleo 0). Aqui só se entrega e recebe dados dela:
  atualizarEnvioLeituraHostinger(); // monta a leitura de 1 em 1 min para o banco
  atualizarEstadoHostinger();  // estado ao vivo para a Hostinger a cada 5 s
  processarComandosRemotos();  // aplica os comandos do painel recebidos pela rede
  mostrarMensagemDaRede();     // mensagens da rede no OLED (ex.: "Vinculado!")
  atualizarVigiaRede();        // Wi-Fi conectado mas sem servidor: reconecta e, se preciso, reinicia

  // Mantém relógio/temporizadores visíveis atualizados mesmo sem mudança de sensor
  if (estadoOLED != OLED_DESCANSO && millis() - ultimoRefreshPeriodicoOLED >= INTERVALO_REFRESH_PERIODICO_MS) {
    ultimoRefreshPeriodicoOLED = millis();
    atualizarOLED = true;
  }

  // Anima a tela de descanso (sol/lua) em quadros curtos
  if (estadoOLED == OLED_DESCANSO && millis() - ultimoFrameAnimacaoDescanso >= INTERVALO_ANIMACAO_DESCANSO_MS) {
    ultimoFrameAnimacaoDescanso = millis();
    atualizarOLED = true;
  }

  DateTime now = obterAgora(); // uma única leitura de "agora" para o resto do ciclo

  controlarLuz(now);   // aplica fotoperíodo/override no relé de luz
  atualizarClima();    // aquecedor e umidificador pelo VPD da fase escolhida
  renderizarOLED(now);  // só efetivamente desenha se atualizarOLED == true
}
