HenriqDV/controlador-cultivo-esp32/src/secrets.h

#pragma once
// =============================================================================
// SEGREDOS REAIS — NÃO COMMITAR. Fica só no seu computador / gravado no ESP32.
// Este arquivo deve estar no .gitignore (já está, na versão atualizada).
// =============================================================================

#define SECRET_WIFI_SSID     "Smurf"
#define SECRET_WIFI_PASSWORD "993728206"

#define SECRET_HOSTINGER_BASE_URL "https://powderblue-rhinoceros-609254.hostingersite.com"
#define SECRET_HOSTINGER_API_KEY  "demetra_oqFeUum8u8a5HniKF2cUrWSHGLuZRhfg"
