HenriqDV/controlador-cultivo-esp32/(commit log)

2026-10-21 v3
    Novas páginas e alertas, troca de fase programada, avisos no Telegram, login mais seguro, vinculação do ESP32 e exportar CSV.
2026-10-29 v4
    Automações do aquecedor e do umidificador, novo Relógio de eventos e página Fotoperíodo.
    Firmware 2.5.0
    - Relés renomeados: 1 Umidificador, 3 Irrigação (pino 39), 4 Entrada de Ar (pino 38), 5 Aquecedor (pino 37)
    - Automações no ESP32 com histerese: aquecedor (liga abaixo do mínimo, desliga no máximo) e umidificador (idem, por umidade)
    - Comando manual no relé pausa a automação dele; sem sensor, desliga por segurança
    Painel
    - Comandos: todos os controles no visual de card; automações com faixa ajustável
    - Relógio de eventos: anéis com os períodos ligados, resumo das 24h, lista Hoje/Ontem e faixa de luz conforme o fotoperíodo (18/6 ou 12/12)
    - Página "Aut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
2026-11-11 v7
    Painel atualiza ao vivo a cada 5 s, usando só a Hostinger
    Relés, fase e horários de luz salvos na flash, e restaurados depois de falta de energia
    Recuperação automática da conexão e watchdog contra travamentos
    Correção dos tempos depois de 49 dias ligado
    Dados do painel agora exigem login
    Código limpo e reorganizado (endpoints PHP e arquivos do painel)
